rbarreiros/FV1-Touch/Build/FTDI Connection.JPG

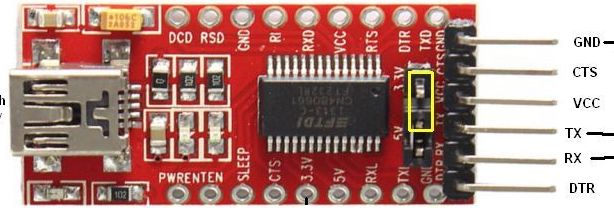
Build/FTDI Connection.JPG
