rbarreiros/FV1-Touch/Build/stm32f103.png

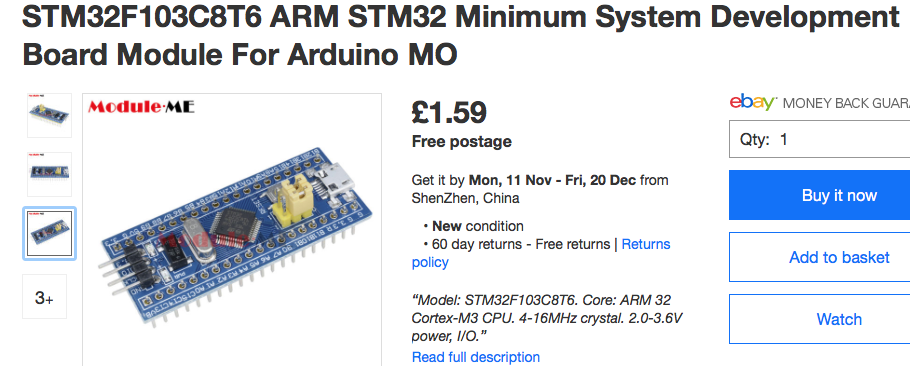
Build/stm32f103.png
