rbarreiros/FV1-Touch/Images/IMG_4687.jpeg

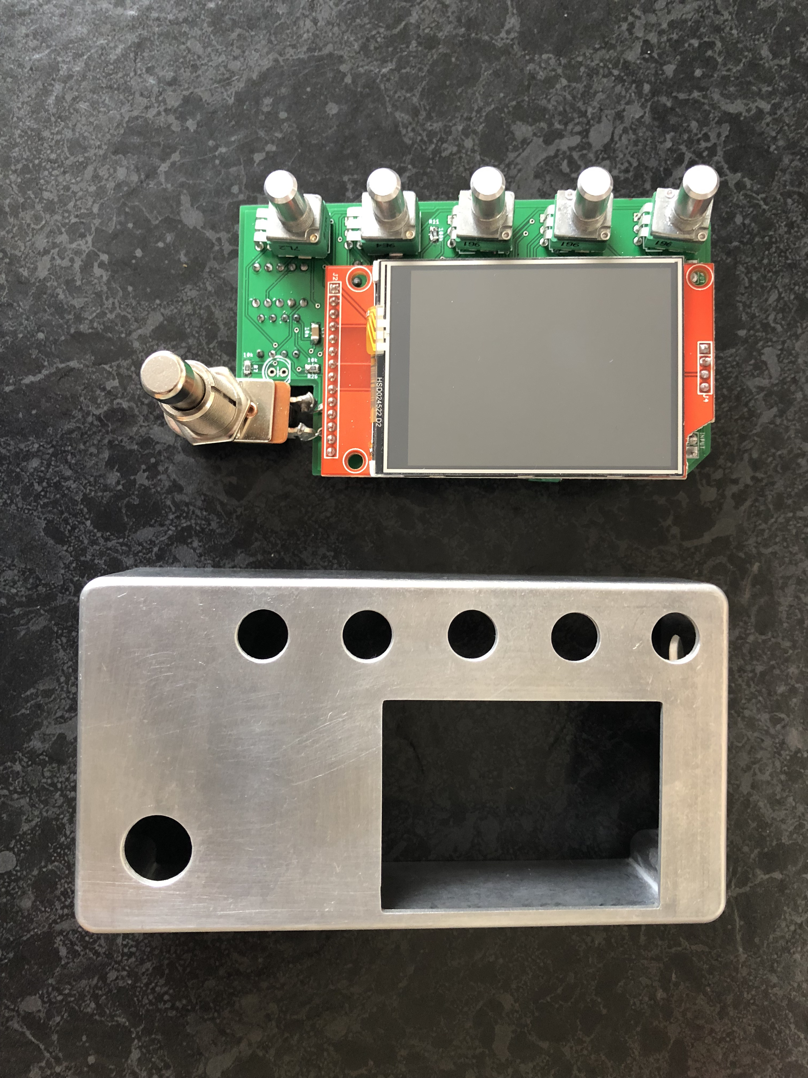
Images/IMG_4687.jpeg
