rbarreiros/FV1-Touch/Images/IMG_5030.JPG

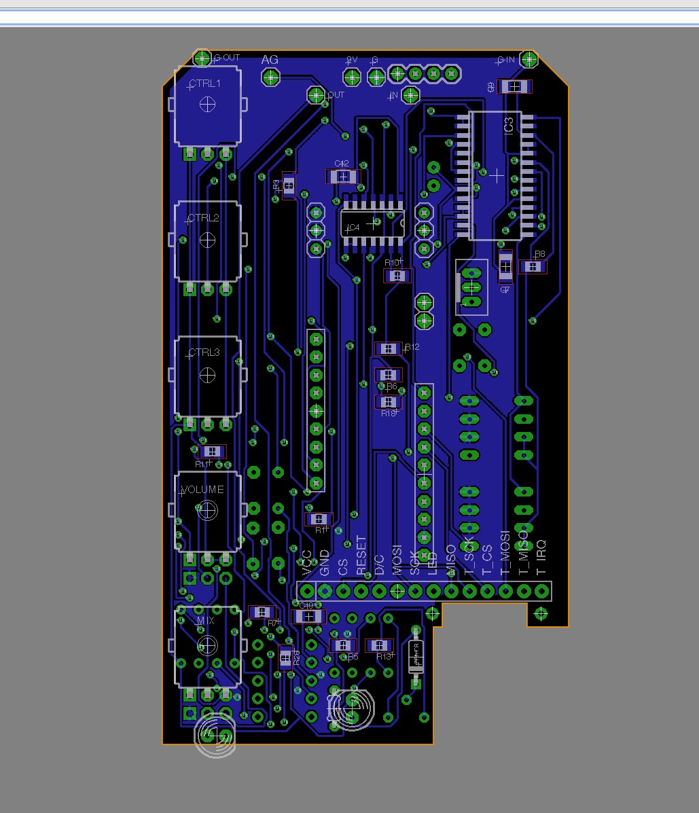
Images/IMG_5030.JPG
