rbarreiros/FV1-Touch/Images/IMG_5032.JPG

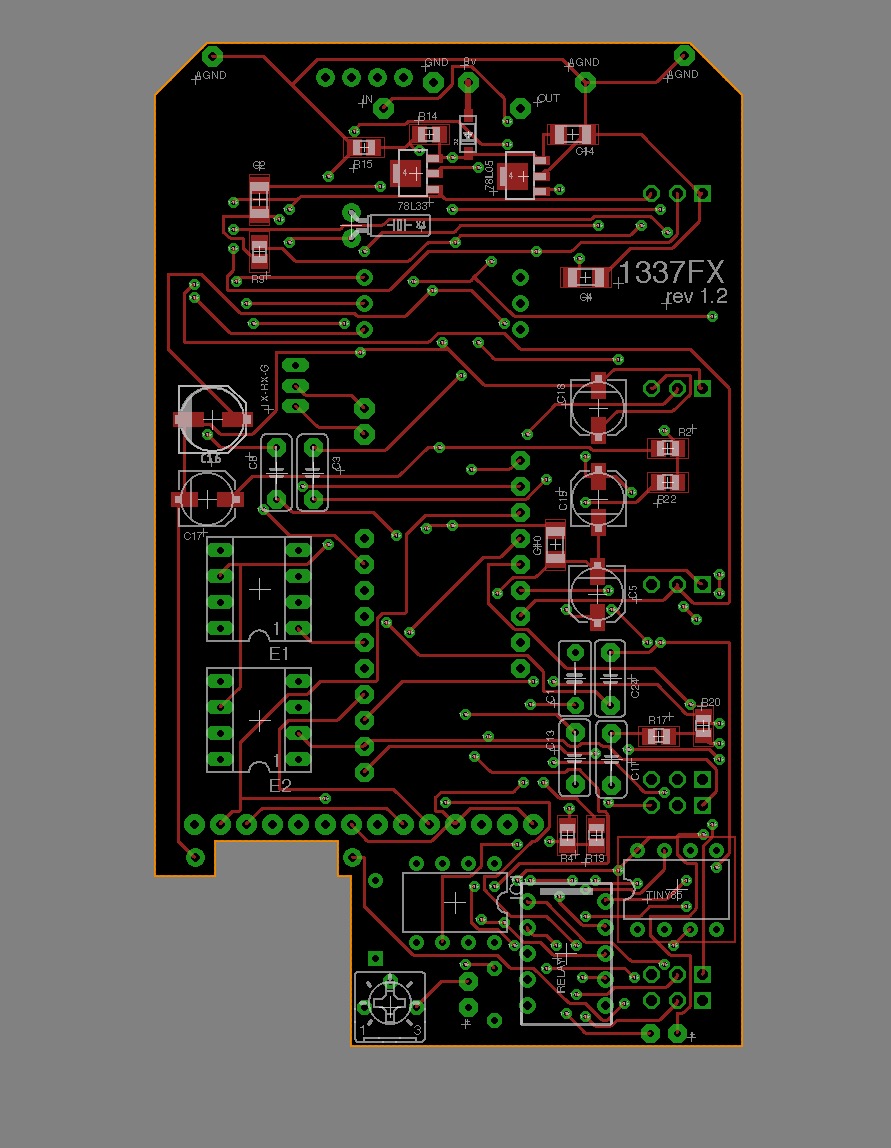
Images/IMG_5032.JPG
