rbarreiros/FV1-Touch/Images/IMG_5121.jpeg

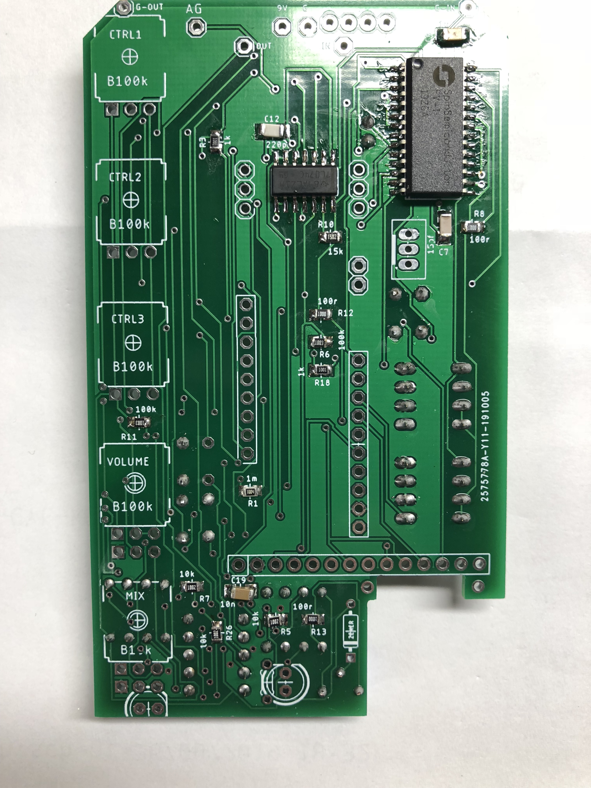
Images/IMG_5121.jpeg
