rbarreiros/FV1-Touch/Images/IMG_5122 2.jpeg

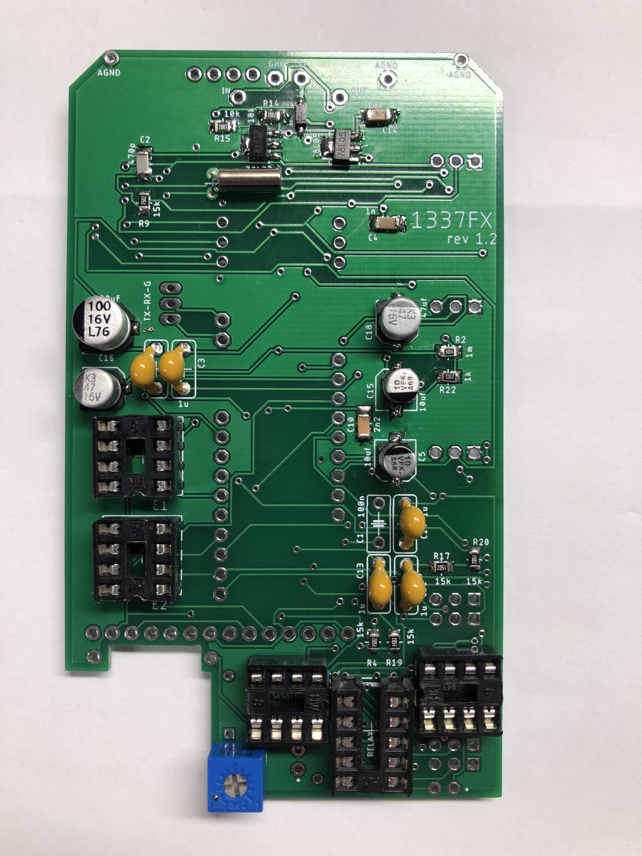
Images/IMG_5122 2.jpeg
