rbarreiros/FV1-Touch/Images/IMG_5137.jpeg

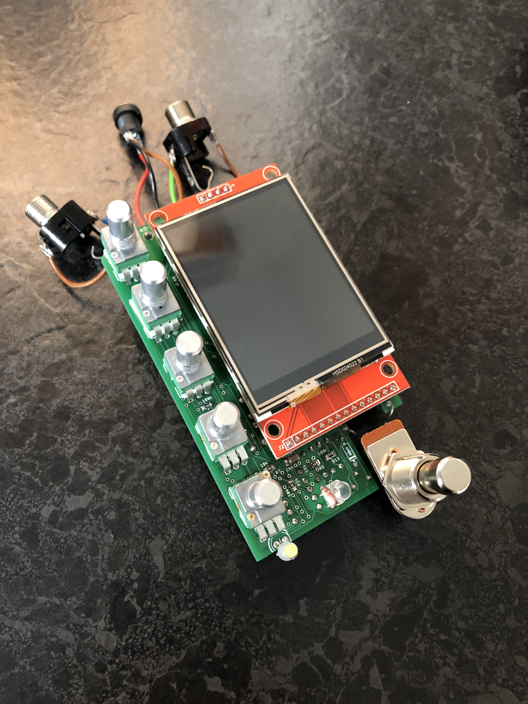
Images/IMG_5137.jpeg
