rbarreiros/FV1-Touch/Images/IMG_5140.jpeg

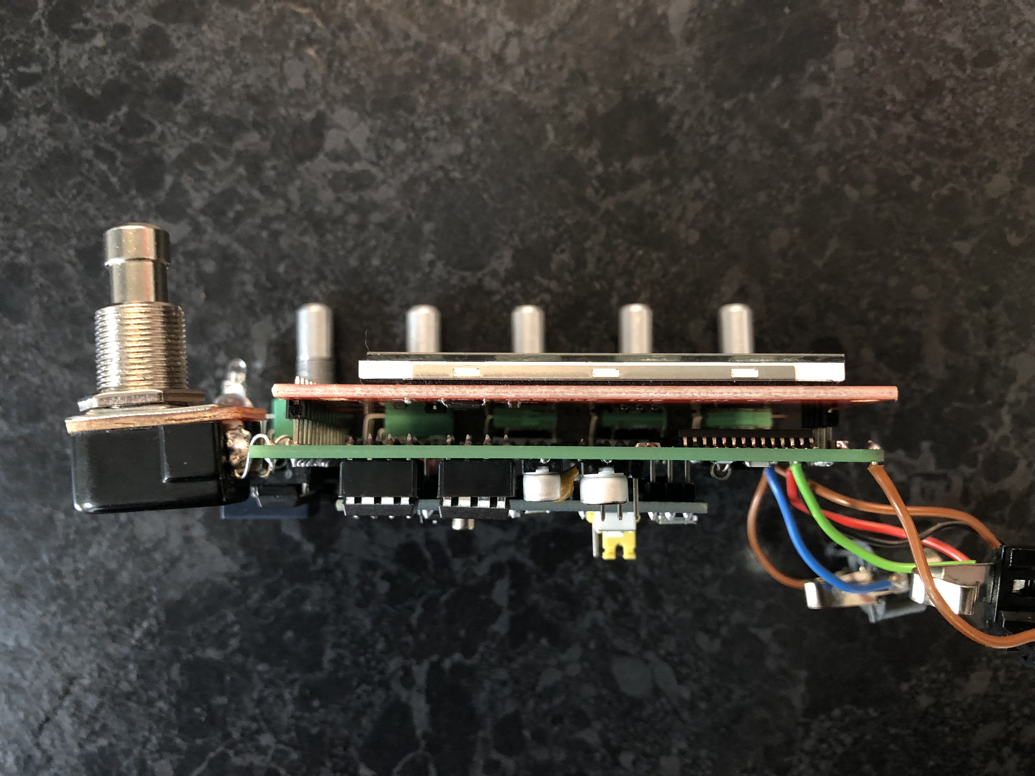
Images/IMG_5140.jpeg
