rbarreiros/FV1-Touch/Images/IMG_5143.jpeg

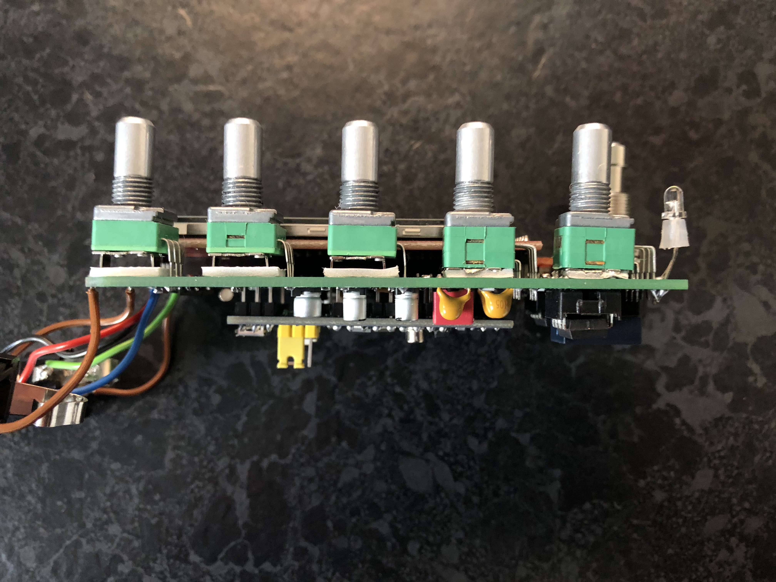
Images/IMG_5143.jpeg
