rbarreiros/FV1-Touch/Images/IMG_5144.jpeg

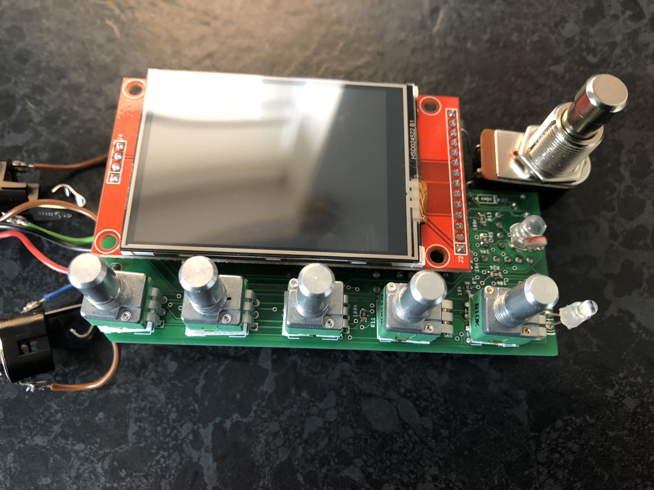
Images/IMG_5144.jpeg
