rbarreiros/FV1-Touch/Images/IMG_5166.jpeg

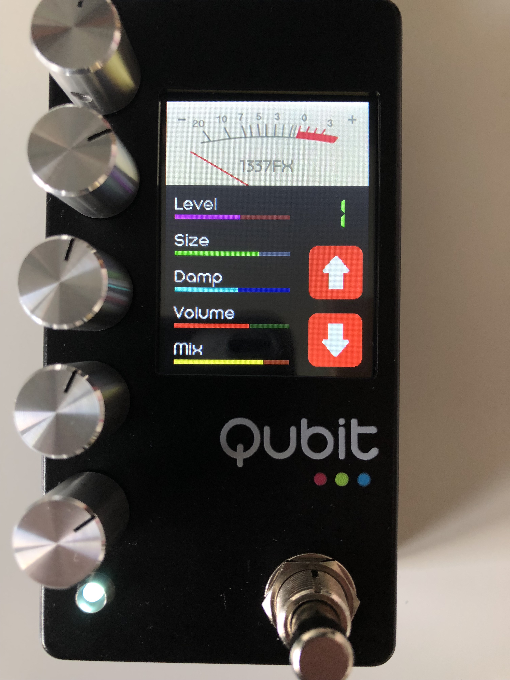
Images/IMG_5166.jpeg
