rbarreiros/FV1-Touch/Images/IMG_5245.jpeg

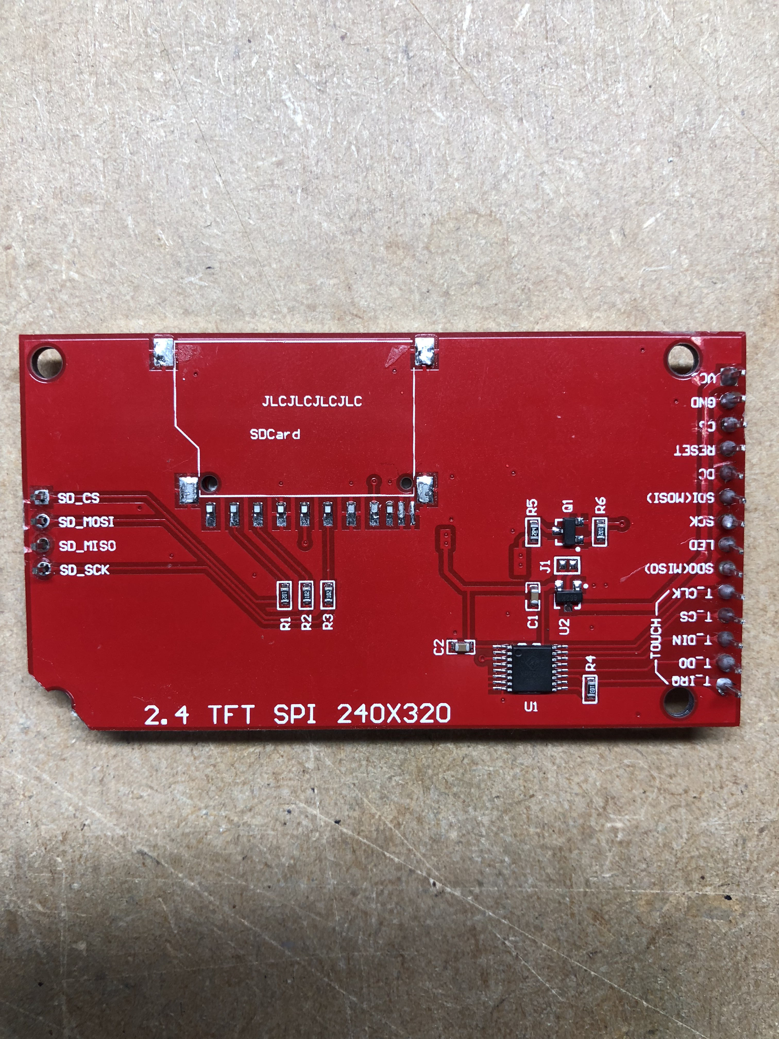
Images/IMG_5245.jpeg
