rbarreiros/FV1-Touch/Images/IMG_5246.jpeg

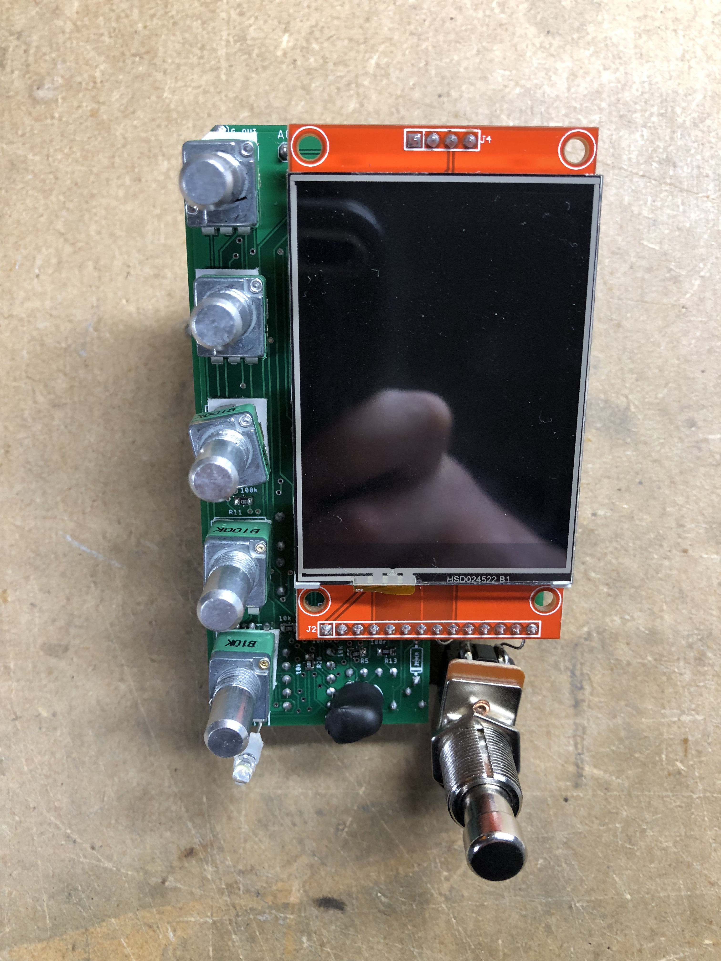
Images/IMG_5246.jpeg
