rbarreiros/FV1-Touch/Images/IMG_5289.jpeg

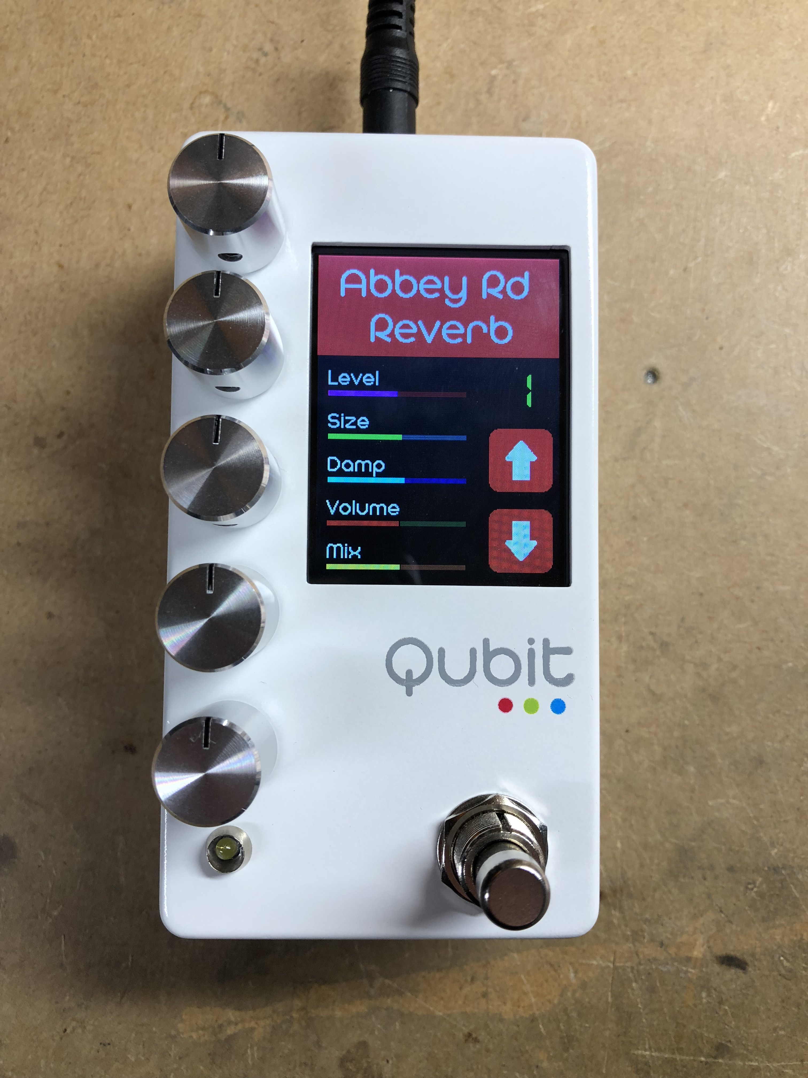
Images/IMG_5289.jpeg
