rbarreiros/FV1-Touch/Images/IMG_5290.jpeg

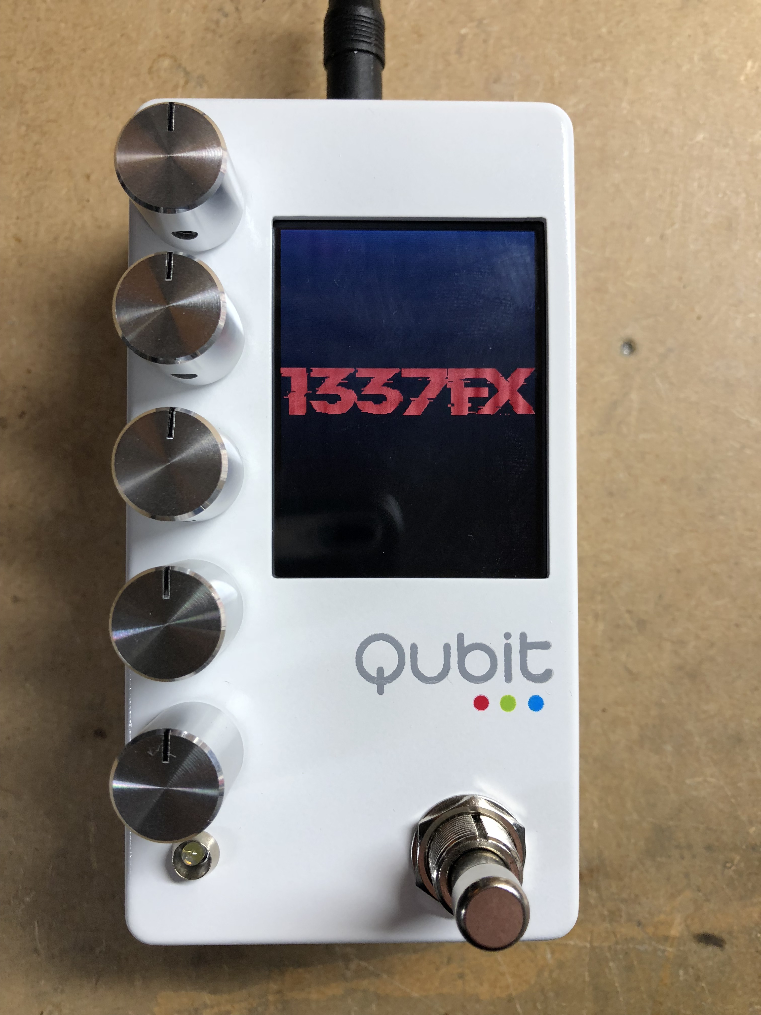
Images/IMG_5290.jpeg
