rbarreiros/FV1-Touch/Images/IMG_5298.jpeg

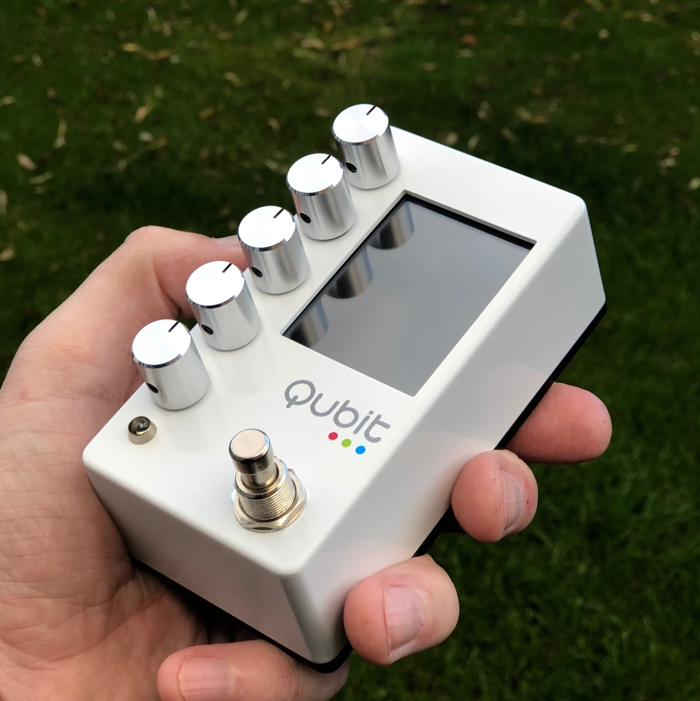
Images/IMG_5298.jpeg
