rbarreiros/FV1-Touch/Spincad/MN3011 Delay.jpg

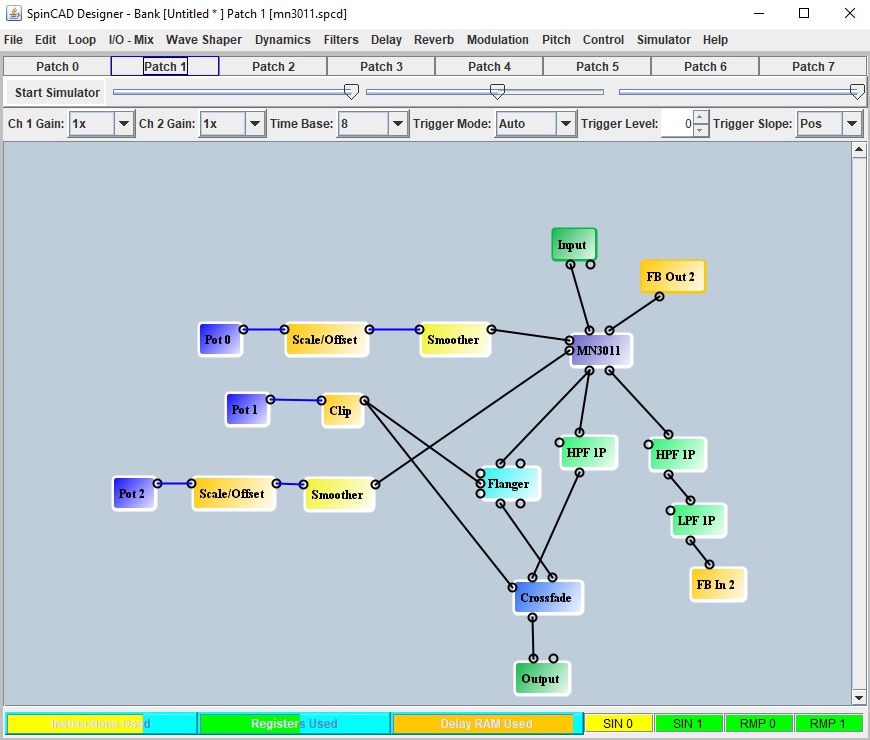
Spincad/MN3011 Delay.jpg
