rbarreiros/FV1-Touch/Spincad/Triple Delay.jpg

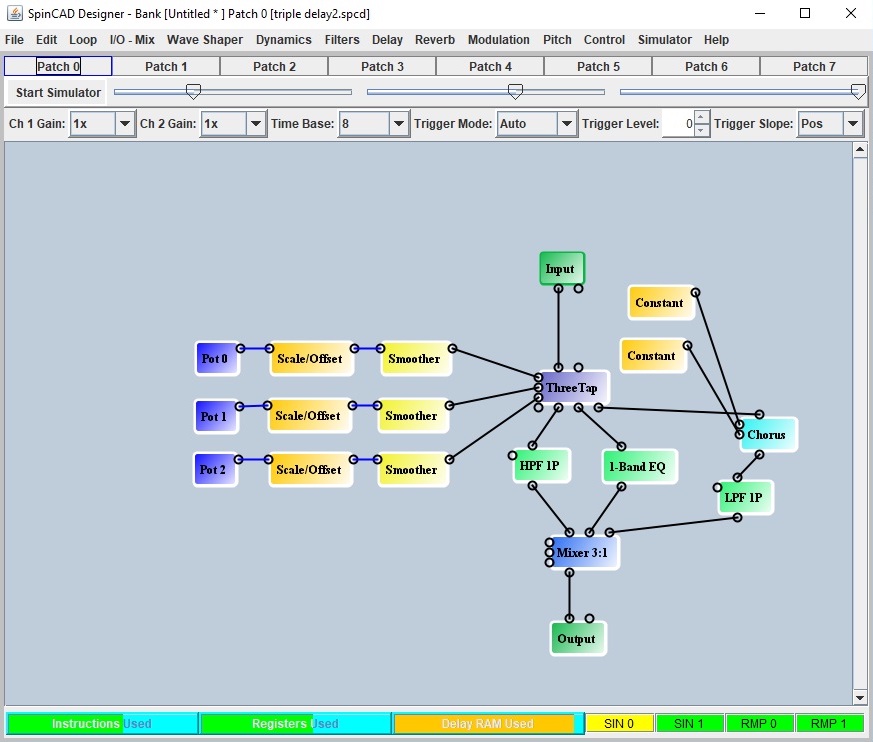
Spincad/Triple Delay.jpg
