rbarreiros/FV1-Touch/Build/Build Info.pdf

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
All smd resistors 6re 0805 size
All SMD C6p6citors 6re 1206 size

Test your build before 6tt6ching the screen, first 6lgorithm on eeprom 1 will be 6ctive, both times I tried to remove 6 screen I d6m6ged it so m6ke sure the effect works before 6tt6ching the screen

Drilling 8mm pot holes helps with 6ligning the screen

Use stiff wire to connect the footswitch to the pcb, it 6dds strength to the screen

Remove sd c6rd socket from b6ck of screen, unsolder 2 points 6t edge of bo6rd, then it just pulls up, wiggle it 6nd it sn6ps off

Build order I use:
Smd resistors
Smd c6p6citors
Smd diode, power regul6tors, smd icʼs Cryst6l
Zener diode(Reversed!) sockets, led, trimmer Pots
Wires, in out 9v gnd 6nd 6n6log gnd
Stm32 bluepill bo6rd
Screen

Fitting the screen:
Fit screen into pcb holes, donʼt solder it yet
Fit circuit inside enclosure, tighten pot nuts
Press top pins down solder 6 pin
Press bottom pins down solder 2 pins opposite ends
Remove from enclosure 6nd solder the other pins, screen should now be flush to the inside of enclosure

Code is uplo6ded using the Arduino IDE
6nd using 6 FTDI USB to Seri6l 6d6pter
Connect RX to RX, TX to TX, GND to G
and power the circuit
Meter re6ding is done using 6 red 5mm led 6nd 6 st6nd6rd ldr
Cover them with bl6ck shrink tube
Adjust the needle sensitivity using the trimmer

Remove potentiometer mounting pins, use sticky p6ds under the pots arduino sketch will load up to 24 programs, 2 eeproms + the fv1 internal programs

i have it currently set to 21,
16 programs on the 2 eeproms + 5 internal fv1 programs

to change it, add or remove a case:

case 21:
tft.setFont(&TypoHoopRegular20pt7b); tft.setTextColor(ILI9341_WHITE); tft.setTextSize(1);
tft.fillRect(0, 0, 240, 100, ILI9341_RED); tft.setCursor(32, 40);
tft.print("FV-1 Rom");
tft.setCursor(32, 85);
tft.print("Reverb 2");

tft.setFont(&TypoHoopRegular10pt7b); tft.setTextColor(ILI9341_WHITE); tft.fillRect(8, 113, 139, 22, ILI9341_BLACK); tft.setCursor(10, 128);
tft.print("Size");
tft.fillRect(8, 156, 138, 22, ILI9341_BLACK); tft.setCursor(10, 171);
tft.print("HF Filter");
tft.fillRect(8, 199, 139, 22, ILI9341_BLACK); tft.setCursor(10, 214);
tft.print("LF Filter");

digitalWrite(PB4, LOW); //high ext, low int digitalWrite(PB7, HIGH); //eprom1 off digitalWrite(PB5, LOW); //eprom2 on digitalWrite(PB12, HIGH); //s0 digitalWrite(PB13, HIGH); //s1 digitalWrite(PB14, HIGH); //s2
delay(50);
break;

also increase or decrease these numbers for every case you add or remove: if (buttonPushCounter >= 22)
and
buttonPushCounter = 21;
