rbarreiros/FV1-Touch/Build/fv1 touch drill.pdf

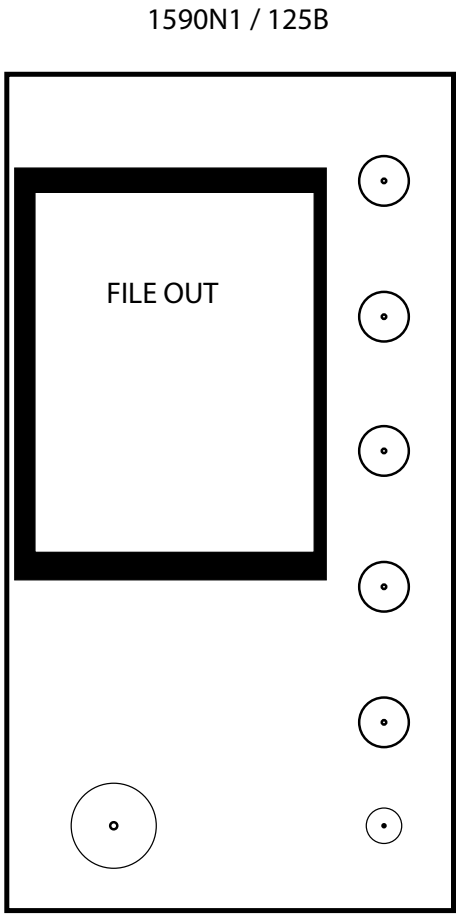
[picture p23: figure]
FILE OUT
