rbarreiros/FV1-Touch/Build/2.4_ ili9341 touch.png

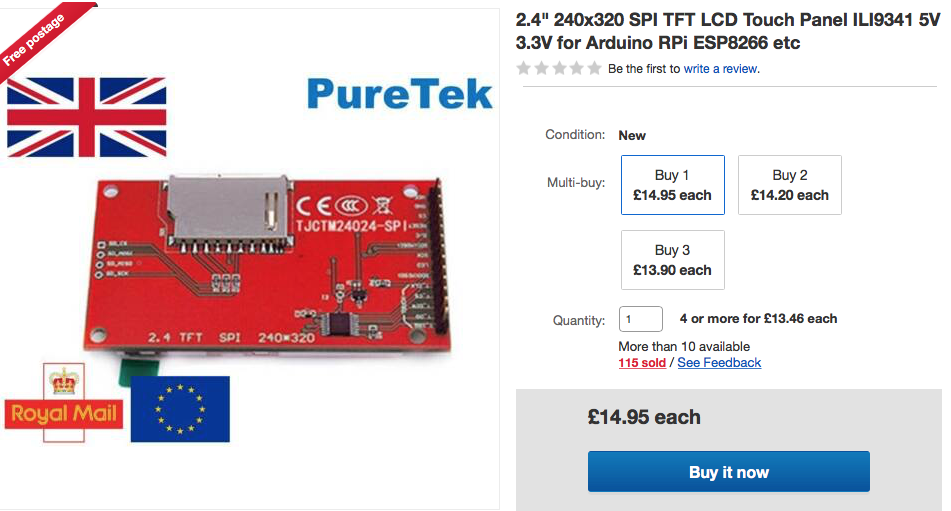
Build/2.4_ ili9341 touch.png
