rbarreiros/FV1-Touch/Build/FTDI.png

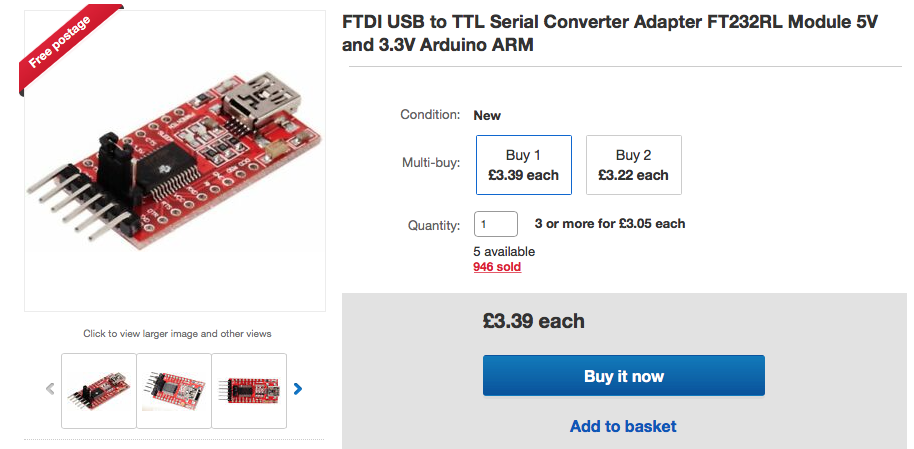
Build/FTDI.png
