rbarreiros/FV1-Touch/(threads)

Thread 1 (2019-11-28):

SPIClass mySPI

leetut, 2019-11-28:
on line 117
SPIClass mySPI(1); //Create an SPI instance on default SPI port (SPI 1)
is missing the (1)
wouldn't compile without it

rbarreiros, 2019-11-28:
I'm surprised it compiled with it, because you're using Dan drown stm32 Arduino port that's why it wouldn't compile, as Dan drown stm32 port requires the spi port in the constructor, but, bounce2 doesn't compile with that stm32 port, hence I use this (more compatible with latest Arduino libraries) stm32duino port:

https://github.com/stm32duino

With this one, spi constructor with default settings doesn't need any parameter and all libs compile properly.

rbarreiros, 2019-11-28:
Check the file header.

Closed 2019-11-29.

Thread 2 (2019-11-28):

disableDebugPorts();

leetut, 2019-11-28:
disableDebugPorts();
is needed to be able to use PB3 & PB4 pins as GPIO pins

rbarreiros, 2019-11-28:
Didn't notice on the schematic they were being used, as its stated in the start of the file, I used another stm32 to Arduino port (a more standard one) that doesn't have that function, shouldn't be hard to port (I would guess all you need is to pinmode those ports)

rbarreiros, 2019-11-28:
After further reading (have no idea how Dan drown stm32 port works) if you use the port I was using, you don't need to call disabledebugports, just set the ports as outputs or inputs.

Closed 2019-11-29.
