rbarreiros/FV1-Touch/Eagle/FV1 Touch.brd

## EAGLE design Eagle/FV1 Touch.brd (2019-11-26)

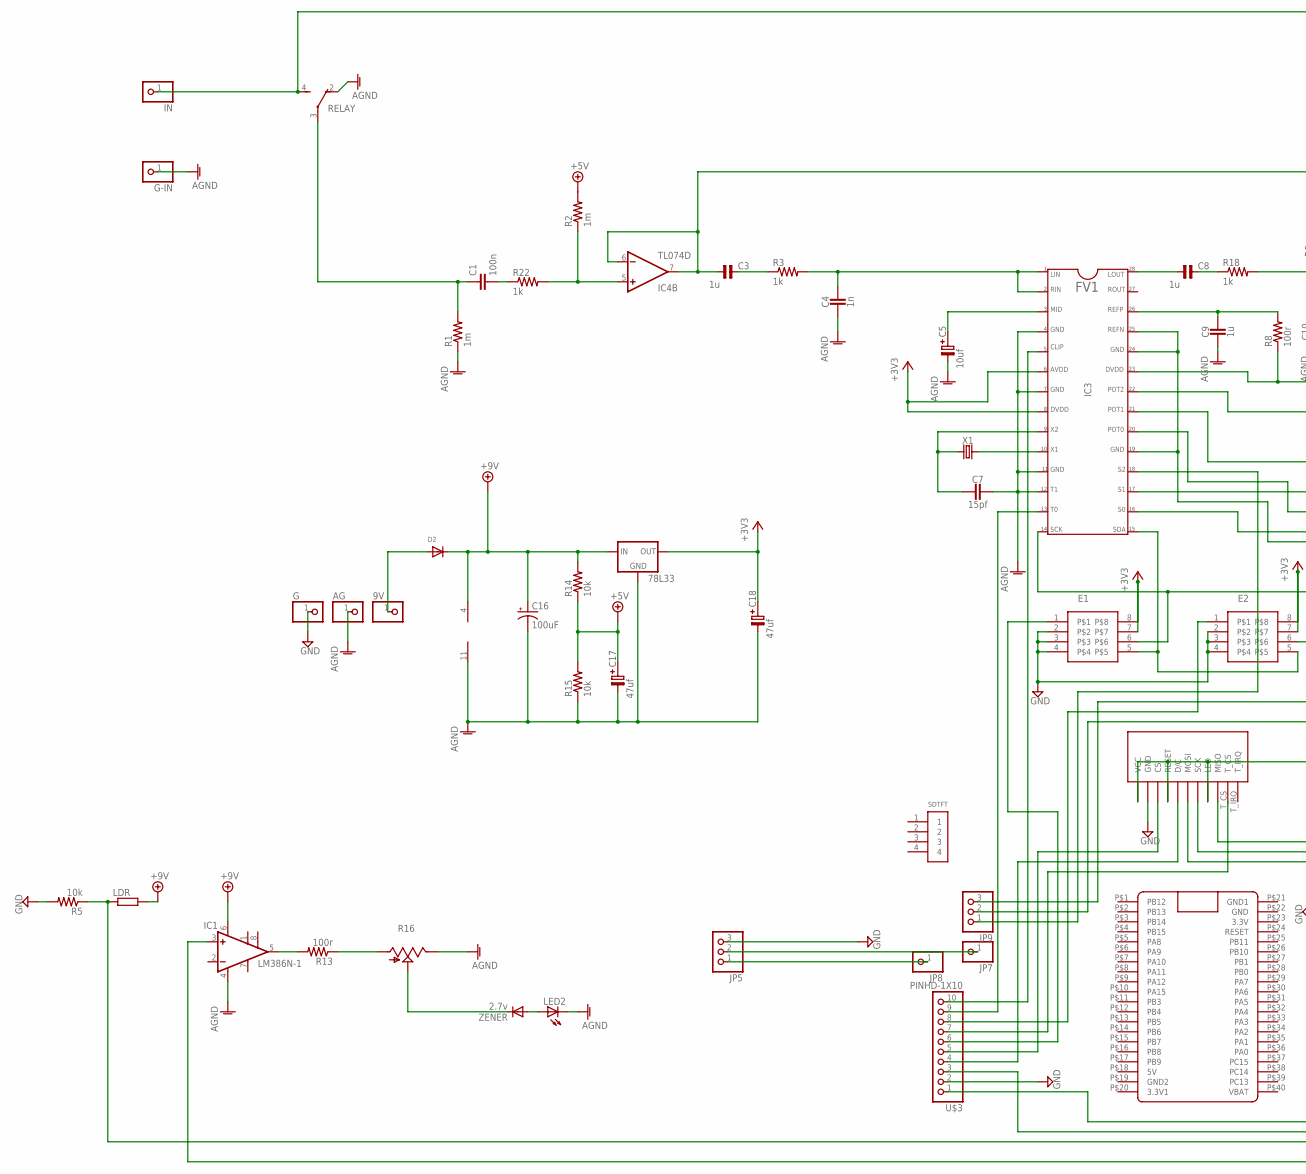
[picture p26: schematic FV1 Touch.sch, part in row 1, column 1]

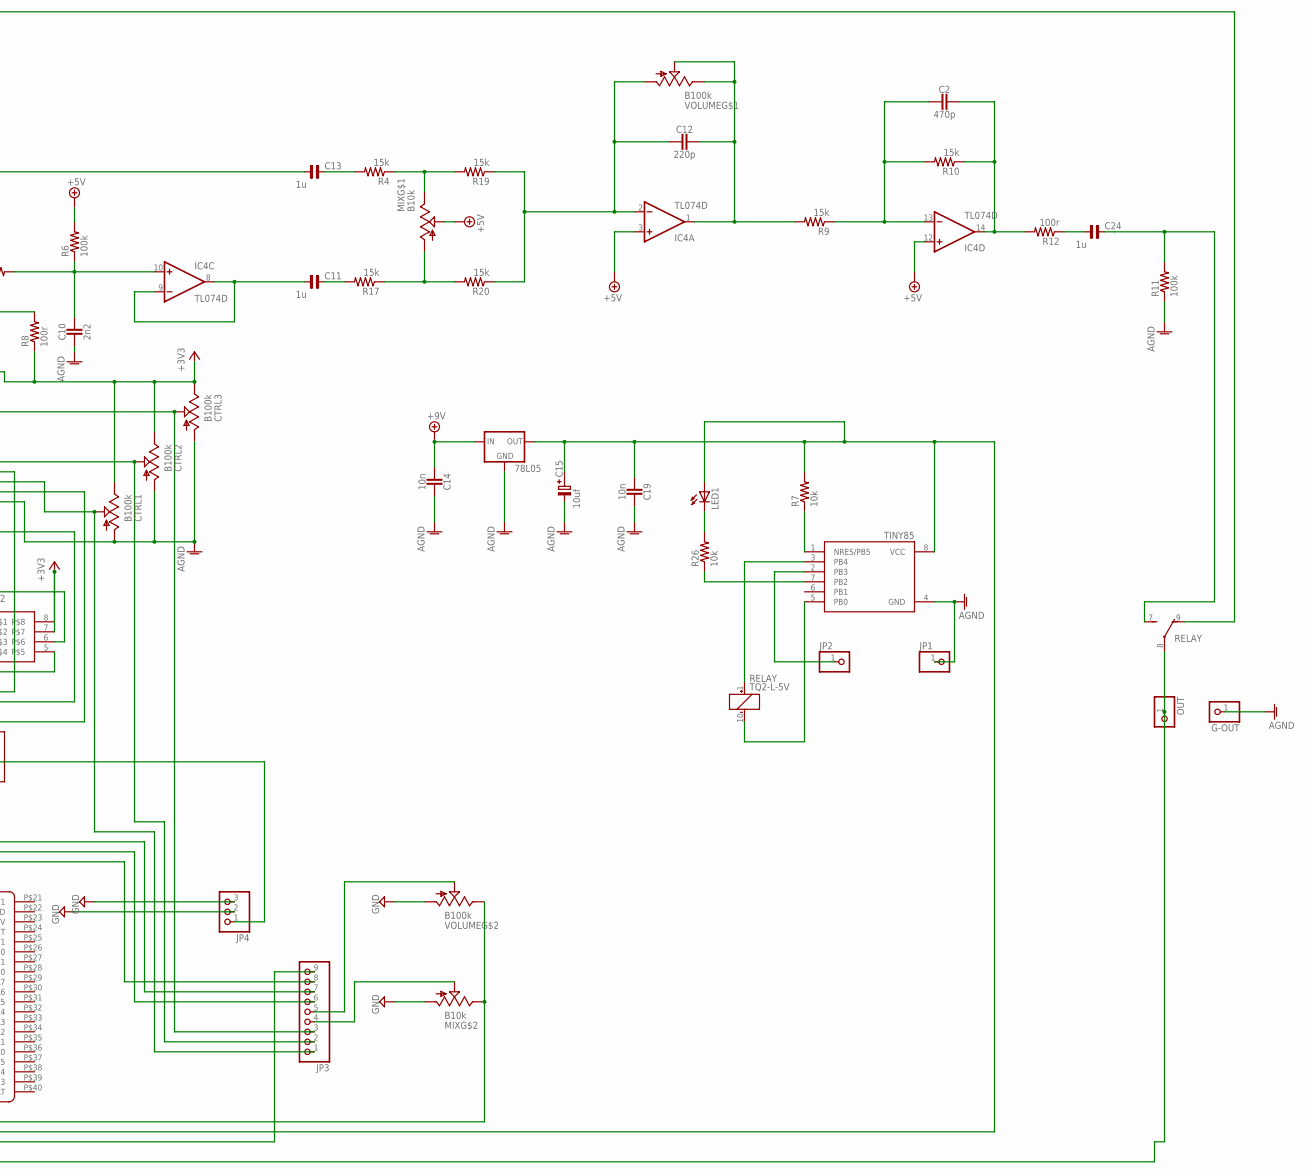
[picture p27: schematic FV1 Touch.sch, part in row 1, column 2]

Parts:
9V: PINHD-1X1; 1X01
78L05, 78L33: 78LXX-SOT89; SOT89
AG: PINHD-1X1; 1X01
C1: 100n; C5B3
C2: 470p; RESISTOR_C1206
C3, C8, C11, C13, C24: 1u; C5,0-7,5X3,0
C4: 1n; RESISTOR_C1206
C5, C15: 10uf; SV-C
C7: 15pf; RESISTOR_C1206
C9: 1u; RESISTOR_C1206
C10: 2n2; RESISTOR_C1206
C12: 220p; RESISTOR_C1206
C14, C19: 10n; RESISTOR_C1206
C16: 100uF; PANASONIC_D
C17, C18: 47uf; SV-C
CTRL1, CTRL2, CTRL3: B100k; 9MM_SNAP-IN_POT
D2: DIODESOD-123; SOD-123
E1, E2: -EEPROM; SOCKED-08
G: PINHD-1X1; 1X01
G-IN: PINHD-1X1; 1X01
G-OUT: PINHD-1X1; 1X01
IC1: LM386N-1; DIL08
IC3: FV1; SO1C28
IC4: TL074D; SO14
IN: PINHD-1X1; 1X01
J1: SPI_TFT_DISPLAY_TOUCH; SPI_DISPLAY_TOUCH
JP1, JP2: PINHD-1X1CB; 1X01-CLEANBIG
JP3: PINHD-1X9; 1X09-BIG
JP4, JP5, JP9: PINHD-1X3; 1X03
JP7, JP8: PINHD-1X1; 1X01
LDR: R-EU_0204/5; 0204/5
LED1, LED2: LED5MM
MIX: B10k; DUAL_9MM_SNAP-IN_POT
OUT: PINHD-1X1; 1X01
R1, R2: 1m; R0805
R3, R18, R22: 1k; R0805
R4, R9, R10, R17, R19, R20: 15k; R0805
R5, R7, R14, R15, R26: 10k; R0805
R6, R11: 100k; R0805
R8, R12, R13: 100r; R0805
R16: TRIM_US-B25P; B25P
RELAY: TQ2-L-5V; TQ2
SDTFT: 1X4-BIG; 1X04-BIG
TINY85: ATTINY85-20P; PDIP08_300MIL
U$1: BLUE_PILL
U$3: PINHD-1X10; 1X10-BIG
VOLUME: B100k; DUAL_9MM_SNAP-IN_POT
X1: CRYSTALPTH-2X6-KIT; CRYSTAL-PTH-2X6-CYL-KIT
ZENER: 2.7v; DO35-7

Connections:
+3V3: 78L33.1 (OUT), C18.+, CTRL1.3 (E), CTRL2.3 (E), CTRL3.3 (E), E1.7, E1.8, E2.7, E2.8, IC3.6, IC3.8, IC3.23, R8.1
+5V: C17.+, IC4.3 (+IN), IC4.12 (+IN), MIX.2 (S), R2.2, R6.2, R14.1, R15.2
+9V: 78L05.3 (IN), 78L33.3 (IN), C14.2, C16.+, D2.C, IC1.6 (VS), IC4.4 (V+), LDR.2, R14.2
AGND: 78L05.2 (GND), 78L33.2 (GND), AG.1, C4.2, C5.-, C7.1, C9.2, C10.2, C14.1, C15.-, C16.-, C17.-, C18.-, C19.1, CTRL1.1 (A), CTRL2.1 (A), CTRL3.1 (A), G-IN.1, G-OUT.1, IC1.4 (GND), IC3.4, IC3.7, IC3.11, IC3.12, IC3.19, IC3.24, IC3.25, IC4.11 (V-), JP1.1, LED2.K (C), R1.1, R11.1, R15.1, R16.E, RELAY.2 (O), TINY85.4 (GND)
GND: E1.2, E1.3, E1.4, E2.2, E2.3, E2.4, G.1, J1.GND, JP4.2, JP4.3, JP5.3, MIX.1B (A), R5.2, U$3.2, VOLUME.1B (A)
GND1: U$1.P$21 (GND1)
unnamed: C1.2, R22.1
unnamed: IC4.5 (+IN), R2.1, R22.2
unnamed: C3.1, C13.1, IC4.6 (-IN), IC4.7 (OUT)
unnamed: C8.1, IC3.28
unnamed: C4.1, IC3.1, IC3.2, R3.2
unnamed: C8.2, R18.1
unnamed: C3.2, R3.1
unnamed: C10.1, IC4.10 (+IN), R6.1, R18.2
unnamed: C11.1, IC4.8 (OUT), IC4.9 (-IN)
unnamed: C11.2, R17.2
unnamed: MIX.1 (A), R17.1, R20.2
unnamed: C24.2, R11.2, RELAY.7 (S)
unnamed: MIX.3 (E), R4.1, R19.2
unnamed: C13.2, R4.2
unnamed: C2.1, IC4.14 (OUT), R10.1, R12.2
unnamed: C24.1, R12.1
unnamed: C1.1, R1.2, RELAY.3
unnamed: C12.2, IC4.2 (-IN), R19.1, R20.1, VOLUME.1 (A)
unnamed: C2.2, IC4.13 (-IN), R9.1, R10.2
unnamed: C12.1, IC4.1 (OUT), R9.2, VOLUME.2 (S), VOLUME.3 (E)
unnamed: J1.CS, U$3.5
unnamed: J1.D/C, U$3.4
unnamed: J1.MOSI, J1.T_MOSI (MOSI), JP3.8
unnamed: C5.+, IC3.3
unnamed: IC3.13, U$3.9
unnamed: CTRL3.2 (S), IC3.22, JP3.3
unnamed: C7.2, IC3.9, X1.1
unnamed: C9.1, IC3.26, R8.2
unnamed: CTRL2.2 (S), IC3.21, JP3.2
unnamed: CTRL1.2 (S), IC3.20, JP3.1
unnamed: J1.SCK, J1.T_SCK (SCK), JP3.6
unnamed: J1.MISO, J1.T_MISO (MISO), JP3.7
unnamed: IC3.10, X1.2
unnamed: J1.T_CS, U$3.7
unnamed: JP5.2, JP7.1
unnamed: E1.6, E2.6, IC3.14
unnamed: E1.5, E2.5, IC3.15
unnamed: JP5.1, JP8.1
unnamed: J1.LED, J1.RESET, J1.VCC, JP4.1
unnamed: IC3.17, JP9.2
unnamed: 9V.1, D2.A
unnamed: IC3.18, JP9.1
unnamed: E1.1, U$3.6
unnamed: JP3.4, MIX.2B (S)
unnamed: 78L05.1 (OUT), C15.+, C19.2, LED1.A, R7.2, TINY85.8 (VCC), U$3.3
unnamed: RELAY.1 (+), TINY85.3 (PB4)
unnamed: R7.1, TINY85.1 (NRES/PB5)
unnamed: RELAY.10 (-), TINY85.5 (PB0)
unnamed: JP2.1, TINY85.2 (PB3)
unnamed: R26.1, TINY85.7 (PB2)
unnamed: LED1.K (C), R26.2
unnamed: IN.1, RELAY.4 (S), RELAY.9 (O)
unnamed: IC1.3 (+IN), OUT.1, RELAY.8
unnamed: JP3.5, VOLUME.2B (S)
unnamed: IC3.16, JP9.3
unnamed: MIX.3B (E), U$3.1, VOLUME.3B (E)
unnamed: R16.S, ZENER.C
unnamed: E2.1, U$3.8
unnamed: IC3.5, U$3.10
unnamed: IC1.5 (OUT), R13.2
unnamed: R13.1, R16.A
unnamed: LED2.A, ZENER.A
unnamed: JP3.9, LDR.1, R5.1

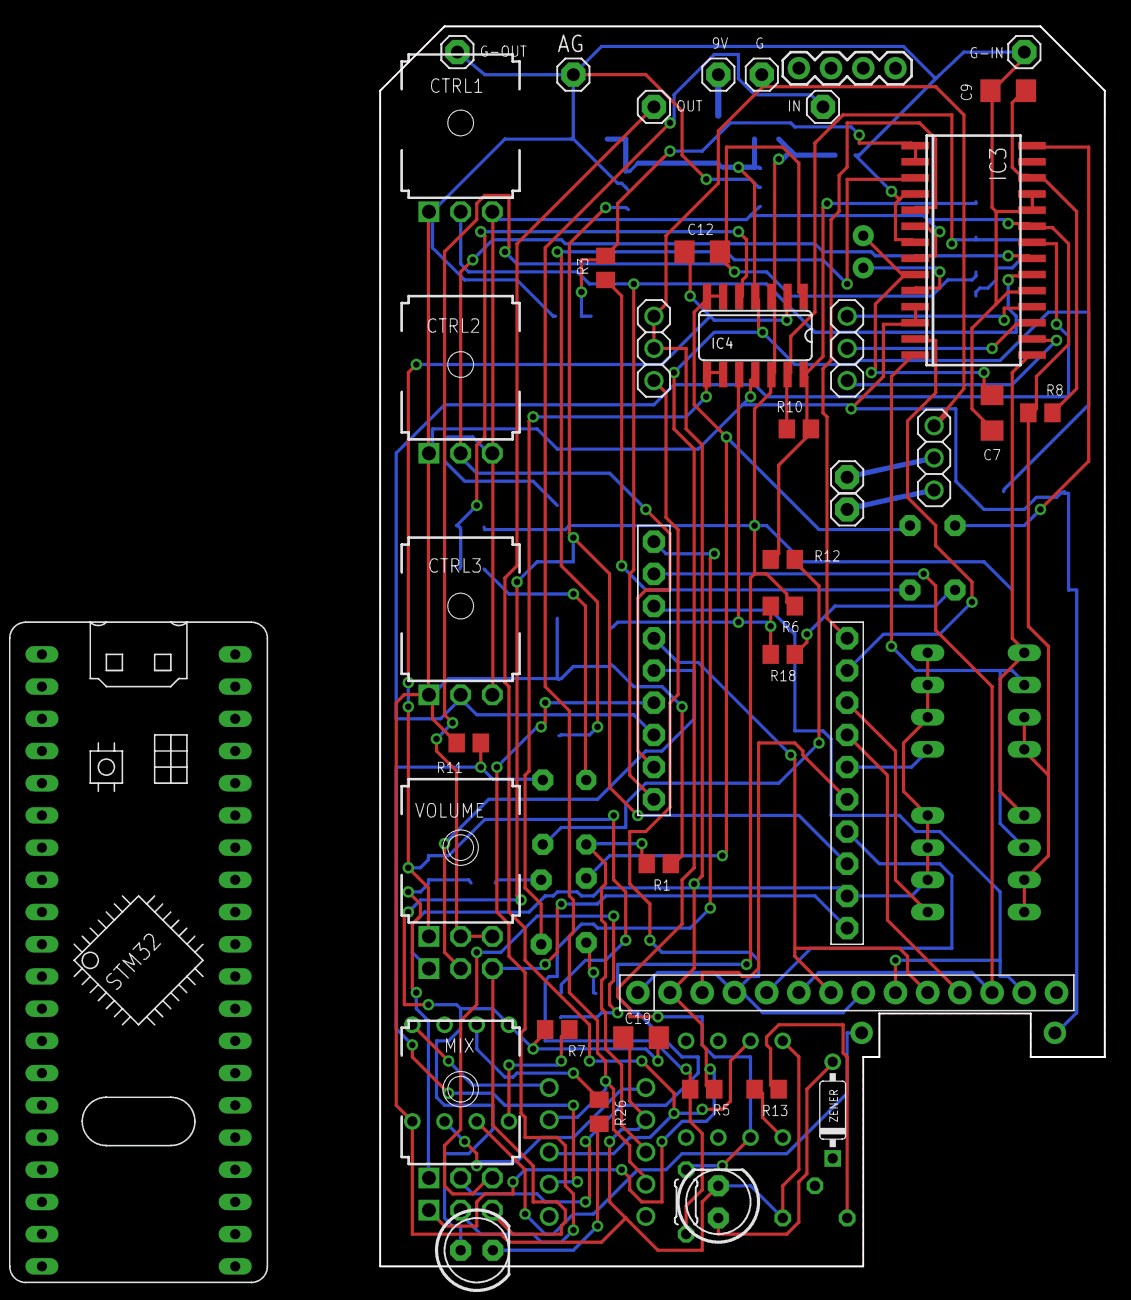
[picture p28: board FV1 Touch.brd from above]

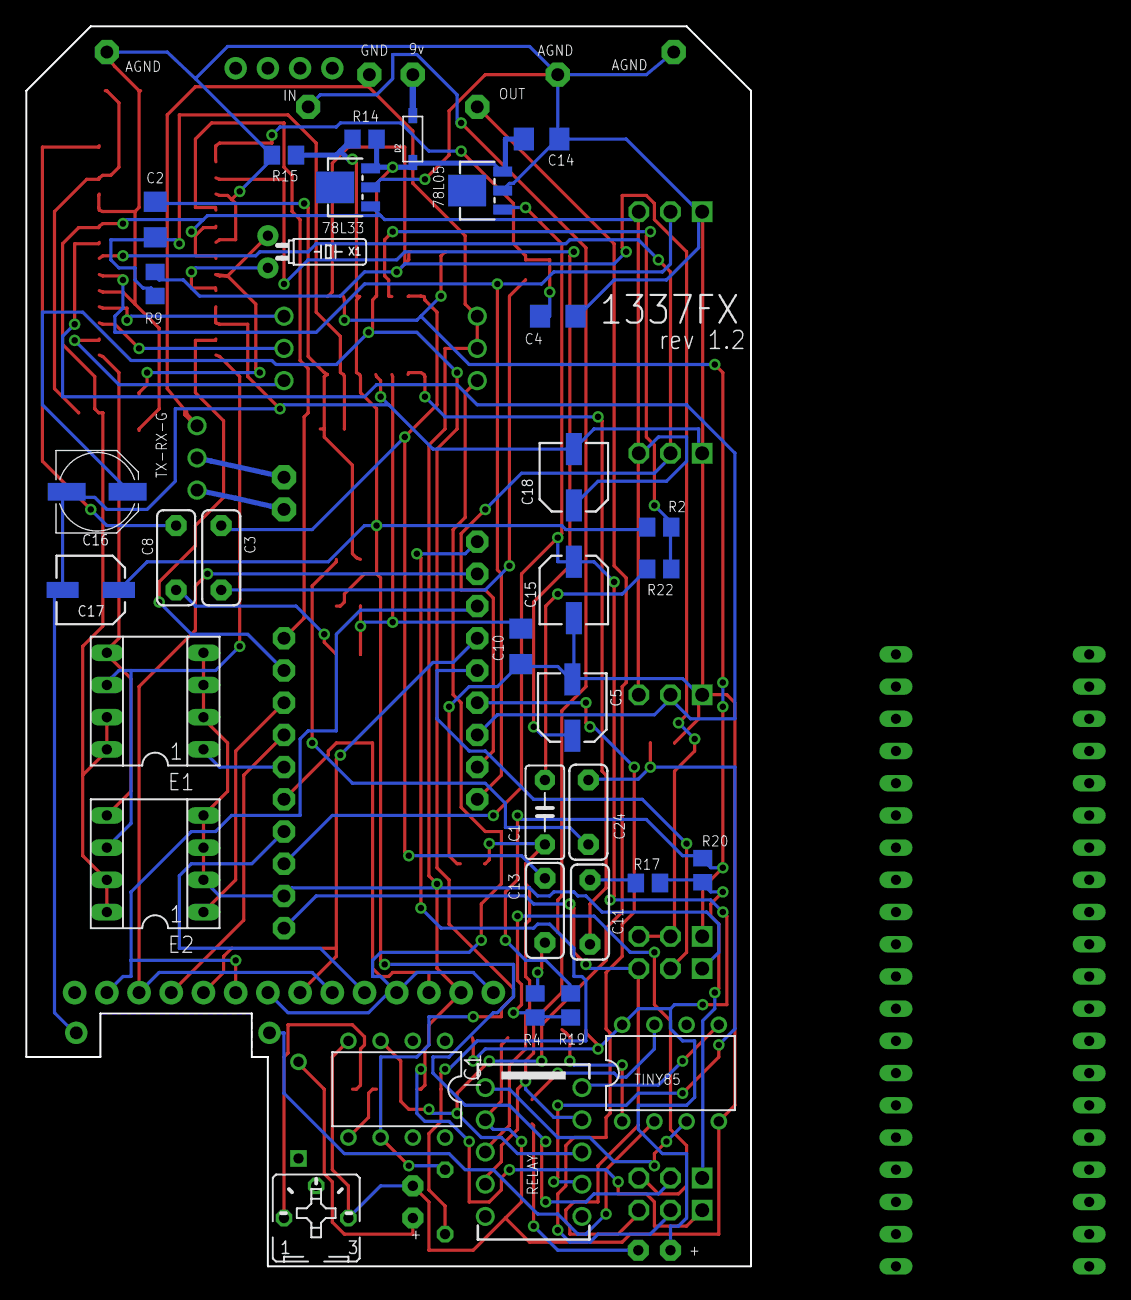
[picture p29: board FV1 Touch.brd from below]

Board: 2 copper layers, 57.1 x 97.8 mm, 80 parts (34 on the bottom side), 68 nets.
