rbarreiros/FV1-Touch/firmware/sketch/TouchPedal.ino

// https://www.facebook.com/1337fx/
// https://www.instagram.com/1337_fx/

/**
 * Use this stm32 arduino version as the others don't play well with other original
 * arduino libs.
 * 
 * https://github.com/stm32duino/BoardManagerFiles/raw/master/STM32/package_stm_index.json
 * 
 * Using arduino-cli to compile and/or upload the sketch
 * 
 * arduino-cli compile -b STM32:stm32:GenF1 --build-properties upload.maximum_size=131072 TouchPedal.ino
 *
 *
 * This sketch requires the following libraries:
 *
 * Adafruit GFX		https://github.com/adafruit/Adafruit-GFX-Library
 * Adafruit ILI9341	https://github.com/adafruit/Adafruit_ILI9341
 * XPT2046 Touchscreen	https://github.com/PaulStoffregen/XPT2046_Touchscreen
 * Bounce2 		https://github.com/thomasfredericks/Bounce2
 * Arduino SPI
 *
 */ 

#include <Adafruit_GFX.h>
#include <Adafruit_ILI9341.h>
#include <XPT2046_Touchscreen.h>
#include <SPI.h>
#include <Bounce2.h>

// Fonts and graphics

#include "TypoHoop20pt.h"
#include "Typohoop10pt.h"
#include "uparrow.h";
#include "downarrow.h";
#include "bootlogo.h";
#include "digi.h";
#include "meter.h";

// Color defines
#include "colors.h"

// Pin defines
#include "pins.h"

// Global variables

int buttonPushCounter = 1;   // counter for the number of button presses
int buttonState       = 0;   // current state of the button
int lastButtonState   = 0;   // previous state of the button
int reading           = 0;
int meterOn           = false;

volatile byte oldPnumber = 0;
volatile byte NewPnumber = 0;

double p1volts;
double p2volts;
double p3volts;
double p4volts;
double p5volts;

boolean graph_1 = true;
boolean graph_2 = true;
boolean graph_3 = true;
boolean graph_4 = true;
boolean graph_5 = true;

float ltx = 0;    // Saved x coord of bottom of needle
uint16_t osx = 80, osy = 80; // Saved x & y coords
uint32_t updateTime = 0;       // time for next update

int old_analog =  -999; // Value last displayed
int old_digital = -999; // Value last displayed

// Relay defaults & helpers

#define DEBOUNCETIME 25
#define RELAYDELAY   15
#define PRIMETIME    1000
#define DOUBLECLICK  1000

uint8_t state = 0;
int primetime = 0;
int relay_address = 0;
unsigned long lastMillis = 0;
unsigned long doubleMillis = 0;

/**
 *                            USB
 *                        -----------
 *          FV1 S0 PB12 - |         |- GND
 *          FV1 S1 PB13 - |         |- GND
 *          FV1 S2 PB14 - |         |- 3V3
 *                 PB15 - |         |- NRST
 *                 PA8  - |         |- PB11 Relay LED
 *                 PA9  - |         |- PB10
 *                 PA10 - |         |- PB1
 *                 PA11 - |         |- PB0  LDR ???
 *                 PA12 - |         |- PA7  MOSI1 (SPI 1)
 *                 PA15 - |         |- PA6  MISO1 (SPI 1)
 *        FV1 Clip PB3  - |         |- PA5  SCK1  (SPI 1)
 *       FV1 PIN13 PB4  - |         |- PA4  POT4 (Volume)
 *         EEPROM2 PB5  - |         |- PA3  POT5 (Mix)
 *  (Touch) CS_PIN PB6  - |         |- PA2  POT3
 *         EEPROM1 PB7  - |         |- PA1  POT2
 *   (TFT)  TFT_CS PB8  - |         |- PA0  POT1
 *   (TFT)  TFT_DC PB9  - |         |- PC15 Relay Switch
 *                 5V   - |         |- PC14 Relay Coil 2
 *                 GND  - |         |- PC13 Relay Coil 1
 *                 3V3  - |         |- VBAT
 *                        -----------
 *                          | | | |
 *                     3V3 -  | |  - GND
 *                      PA13 -   - PA14
 * 
*/

// Global classes

Adafruit_ILI9341 tft(TFT_CS, TFT_DC);
SPIClass mySPI; //Create an SPI instance on default SPI port (SPI 1)
XPT2046_Touchscreen ts(CS_PIN); // Chip Select pin, SPI port
Bounce sw = Bounce();

void splashScreen(void)
{
  tft.drawBitmap(0, 130, boot, 240, 44, RED);
  delay (100);
  tft.drawBitmap(0, 130, boot, 240, 44, BLUE);
  tft.drawBitmap(0, 130, boot, 240, 44, RED);
  delay (100);
  tft.drawBitmap(0, 130, boot, 240, 44, BLUE);
  tft.drawBitmap(0, 130, boot, 240, 44, RED);

  delay (1000);

  tft.fillScreen(ILI9341_BLACK);
  tft.setFont(&TypoHoopRegular20pt7b);
  tft.setTextColor(ILI9341_WHITE);
  tft.setTextSize(1);
  tft.fillRect(0, 0, 240, 100, ILI9341_RED);
  tft.setCursor(67, 40);
  tft.print("Qubit");
  tft.setCursor(67, 85);
  tft.print("Delay");

  tft.setFont(&TypoHoopRegular10pt7b);
  tft.setTextColor(ILI9341_WHITE);
  tft.fillRect(8, 113, 139, 22, ILI9341_BLACK);
  tft.setCursor(10, 128);
  tft.print("Time");
  tft.fillRect(8, 156, 138, 22, ILI9341_BLACK);
  tft.setCursor(10, 171);
  tft.print("Modulation");
  tft.fillRect(8, 199, 139, 22, ILI9341_BLACK);
  tft.setCursor(10, 214);
  tft.print("Feedback");
  tft.setCursor(10, 257);
  tft.print("Volume");
  tft.setCursor(10, 300);
  tft.print("Mix");

  tft.fillRect(179, 182, 40, 45, ILI9341_WHITE);
  tft.fillRect(179, 260, 40, 45, ILI9341_WHITE);
  tft.drawBitmap(170, 170, upbutton, 64, 64, ILI9341_RED);
  tft.drawBitmap(170, 250, downbutton, 64, 64, ILI9341_RED);

  tft.setFont(&DSEG7_Classic_Mini_Bold_38);
  tft.fillRect(165, 105, 70, 50, ILI9341_BLACK);
  tft.setTextColor(ILI9341_GREEN);
  tft.setTextSize(1);
  tft.setCursor(185, 152);
  tft.print(buttonPushCounter);
}

/**
 * effectOn 
 *
 * Turns effect relay on
 */
void effectOn(void)
{
  digitalWrite(RELAY_LED, LOW);
  digitalWrite(RELAY1, HIGH);
  delay(RELAYDELAY);
  digitalWrite(RELAY1, LOW);
  state = 1;
}

/**
 * effectOff
 * 
 * Turn effect relay off
 */
void effectOff(void)
{
  digitalWrite(RELAY_LED, HIGH);
  digitalWrite(RELAY2, HIGH);
  delay(RELAYDELAY);
  digitalWrite(RELAY2, LOW);
  state = 0;
}


/**
 * setup
 * 
 * sets up all I/O, hardware and initializes stuff
 * 
 */
void setup() 
{
  // FV1 Pins
  pinMode(PB12, OUTPUT); //S0
  pinMode(PB13, OUTPUT); //S1
  pinMode(PB14, OUTPUT); //S2
  pinMode(PB3, INPUT); // fv1 clip
  pinMode(PB4, OUTPUT); //fv1 pin13, high ext, low int

  pinMode(PB7, OUTPUT); //select eeprom1
  pinMode(PB5, OUTPUT); //select eeprom2

  pinMode(PA0, INPUT); // pot1
  pinMode(PA1, INPUT); // pot2
  pinMode(PA2, INPUT); // pot3
  pinMode(PA4, INPUT); // pot4 volume
  pinMode(PA3, INPUT); // pot5 mix

  // Analog meter input is PB0

  digitalWrite(PB7, LOW);  // EEPROM1 on
  digitalWrite(PB5, HIGH); // EEPROM2 off
  digitalWrite(PB4, HIGH); // high ext, low int
  delay (100);
  digitalWrite(PB12, HIGH); //s0
  digitalWrite(PB13, HIGH); //s1
  digitalWrite(PB14, HIGH); //s2

  // True bypass relay
  pinMode(RELAY_SWITCH, INPUT_PULLUP);
  digitalWrite(RELAY_SWITCH, HIGH); // internal pullup
  digitalWrite(RELAY_LED, HIGH); // led off
  pinMode(RELAY_LED, OUTPUT);
  digitalWrite(RELAY1, LOW);
  digitalWrite(RELAY2, LOW);
  pinMode(RELAY1, OUTPUT);
  pinMode(RELAY2, OUTPUT);

  // Please, most of us already use high speed serial !!
  // no more 9600 stuff ! :)
  Serial.begin(115200);
  mySPI.begin();
  tft.begin();
  ts.begin();
  ts.setRotation(1);
  while (!Serial && (millis() <= 1000));
  tft.fillScreen(ILI9341_BLACK);
  tft.setRotation(0);

  splashScreen();

  digitalWrite(PB12, LOW); //s0
  digitalWrite(PB13, LOW); //s1
  digitalWrite(PB14, LOW); //s2

  // Configure the Debouncer
  sw.attach(RELAY_SWITCH, INPUT_PULLUP);
  sw.interval(DEBOUNCETIME);
  effectOff();

  // Signal the user we're ready  blinking
  // bypass led three times
  digitalWrite(RELAY_LED, HIGH); delay(300);
  digitalWrite(RELAY_LED, LOW); delay(300);
  digitalWrite(RELAY_LED, HIGH); delay(300);
  digitalWrite(RELAY_LED, LOW); delay(300);
  digitalWrite(RELAY_LED, HIGH); delay(300);
  digitalWrite(RELAY_LED, LOW); delay(300);
  digitalWrite(RELAY_LED, HIGH);

  updateTime = millis(); // Next update time
  lastMillis = updateTime;
}

void loop()
{
  const uint32_t analogReadInterval = 1;

  // Process button first, to get it ouf ot the way asap
  // and at the same time, keep the on/off more responsive
  if(sw.update())
  {
    if(sw.fell()) 
    {
      if(state == 1)
       effectOff();
      else
       effectOn();
      
      lastMillis = millis();
    }
    else
    {
      if(primetime == 1) 
      {
        effectOff();
        primetime = 0;
      }
    }
  }

  if(state == 1 && (millis() - lastMillis > PRIMETIME) && primetime == 0)
  {
    if(!sw.read()) 
    {
      primetime = 1;
      digitalWrite(RELAY_LED, HIGH); delay(50);
      digitalWrite(RELAY_LED, LOW);  delay(50);
      digitalWrite(RELAY_LED, HIGH); delay(50);
      digitalWrite(RELAY_LED, LOW);
    }
  }

  if (millis() - updateTime >= analogReadInterval) 
  {
    updateTime += analogReadInterval;
    int raw = analogRead(PB0);
    Serial.print("Raw: "), Serial.println(raw);
    reading = map(raw, 0, 4195, 0, 100);
    
    if (meterOn == true)
      plotNeedle(reading, 0); // Draw needle
  }

  p1volts = analogRead(PA0);
  p2volts = analogRead(PA1);
  p3volts = analogRead(PA2);
  p4volts = analogRead(PA4);
  p5volts = analogRead(PA3);

  DrawBarChartP1(tft, 10, 134, 140, 7, 0, 4195 , 409, p1volts, 0, 0, PINK,   DKRED,    BLACK, WHITE, BLACK, "POT1", graph_1);
  DrawBarChartP1(tft, 10, 177, 140, 7, 0, 4195 , 409, p2volts, 0, 0, GREEN,  DKGREY,   BLACK, WHITE, BLACK, "POT2", graph_2);
  DrawBarChartP1(tft, 10, 220, 140, 7, 0, 4195 , 409, p3volts, 0, 0, CYAN,   DKBLUE,   BLACK, WHITE, BLACK, "POT3", graph_3);
  DrawBarChartP1(tft, 10, 263, 140, 7, 0, 4195 , 409, p4volts, 0, 0, RED,    DKGREEN,  BLACK, WHITE, BLACK, "POT4", graph_4);
  DrawBarChartP1(tft, 10, 306, 140, 7, 0, 4195 , 409, p5volts, 0, 0, YELLOW, DKORANGE, BLACK, WHITE, BLACK, "POT5", graph_5);
}

/**
 * switchEffect
 * 
 * switches the current effect
 * changes the UI and loads the effect
 * from FV1
 * 
 * eeprom : either 1 or 2 (any other value is ignored)
 * fxnum : effect number, from 0 to 7
 */
void switchEffect(const char *fxname, uint16_t fxnameX, uint16_t fxnameY,
                  const char *fxtype, uint16_t fxtypeX, uint16_t fxtypeY,
                  const char *knob1,
                  const char *knob2,
                  const char *knob3,
                  bool external, uint8_t eeprom, uint8_t fxnum)
{
  tft.setFont(&TypoHoopRegular20pt7b);
  tft.setTextColor(ILI9341_WHITE);
  tft.setTextSize(1);
  tft.fillRect(0, 0, 240, 100, ILI9341_RED);
  tft.setCursor(fxnameX, fxnameY);
  tft.print(fxname);
  tft.setCursor(fxtypeX, fxtypeY);
  tft.print(fxtype);

  tft.setFont(&TypoHoopRegular10pt7b);
  tft.setTextColor(ILI9341_WHITE);
  tft.fillRect(8, 113, 139, 22, ILI9341_BLACK);
  tft.setCursor(10, 128);
  tft.print(knob1);
  tft.fillRect(8, 156, 138, 22, ILI9341_BLACK);
  tft.setCursor(10, 171);
  tft.print(knob2);
  tft.fillRect(8, 199, 139, 22, ILI9341_BLACK);
  tft.setCursor(10, 214);
  tft.print(knob3);

  // Switch effect

  // External or internal effect
  // High external eeprom, low internal
  digitalWrite(PB4, (external) ? HIGH : LOW);

  // Switch between the 2 eeproms
  if(eeprom == 1)
  {
    digitalWrite(PB7, LOW); //eprom1 on
    digitalWrite(PB5, HIGH); //eprom2 off
  }
  else if(eeprom == 2)
  {
    digitalWrite(PB7, HIGH); //eprom1 off
    digitalWrite(PB5, LOW); //eprom2 on
  }

  // Load FX
  digitalWrite(PB12, HIGH && (fxnum & B00000100)); // S0
  digitalWrite(PB13, HIGH && (fxnum & B00000010)); // S1
  digitalWrite(PB14, HIGH && (fxnum & B00000001)); // S2
  delay(50);
}

/**
 * DrawBarChartP1
 * 
 * Draw Pot values
 */
void DrawBarChartP1(Adafruit_ILI9341 & d, double x , double y , 
                    double w, double h , double loval , double hival , 
                    double inc , double curval ,  int dig , int dec, 
                    unsigned int barcolor, unsigned int voidcolor, 
                    unsigned int bordercolor, unsigned int textcolor, 
                    unsigned int backcolor, String label, boolean & redraw)
{
  double stepval, range;
  double mx, level;
  double i, data;

  if (redraw == true) 
  {
    redraw = false;
    d.drawRect(x , y , w, h, bordercolor);
    stepval =  inc * (double (w) / (double (hival - loval))) - .001;
    for (i = 0; i <= w; i += stepval) {}
  }

  level = (w * (((curval - loval) / (hival - loval))));
  d.fillRect(x + level + 1, y + 1, w - level - 2, h - 2,  voidcolor);
  d.fillRect(x + 1, y + 1 , level - 1,  h - 2, barcolor);
  int sensorValue = analogRead(PB0);

  // Touchscreen

  if (ts.touched()) 
  {
    TS_Point p = ts.getPoint();

    // Button Code
    if (buttonState != lastButtonState)   // compare the buttonState to its previous state
      // save the current state as the last state, for next time through the loop
      lastButtonState = buttonState;

    // Ive had some ili9341 screens with flipped touch pixels,
    // change screen type if up & down & meter buttons dont work, in 3 places below

    if ((p.x > 1350) && (p.x < 2020) && (p.y > 340) && (p.y < 1450)) // Screen type 1
      //if ((p.x < 2762) && (p.x > 2104) && (p.y > 428) && (p.y < 1500)) // Screen type 2
      buttonPushCounter++;

    if (buttonPushCounter >= 22)
      buttonPushCounter = 1;

    meterOn = false;
    delay(200);
    
    if ((p.x > 480) && (p.x < 1100) && (p.y > 340) && (p.y < 1450)) // Screen type 1
      //if ((p.x < 3598) && (p.x > 2998) && (p.y > 428) && (p.y < 1500)) // Screen type 2
      buttonPushCounter--;
    if (buttonPushCounter <= 0)
      buttonPushCounter = 21;
    
    meterOn = false;
      
    if (buttonPushCounter <= 9)
    {
      tft.fillRect(165, 105, 70, 50, ILI9341_BLACK);
      tft.setTextColor(ILI9341_GREEN);
      tft.setTextSize(1);
      tft.setCursor(185, 152);
      tft.setFont(&DSEG7_Classic_Mini_Bold_38);
      tft.print(buttonPushCounter);
    }

    if (buttonPushCounter >= 10)
    {
      tft.fillRect(165, 105, 70, 50, ILI9341_BLACK);
      tft.setTextColor(ILI9341_GREEN);
      tft.setTextSize(1);
      tft.setCursor(165, 152);
      tft.setFont(&DSEG7_Classic_Mini_Bold_38);
      tft.print(buttonPushCounter);
    }

    switch (buttonPushCounter)
    {
      case 1:
        switchEffect("Qubit", 67, 40,
                     "Delay", 67, 85,
                     "Time", "Modulation", "Feedback",
                     1, 1, 0);
        break;
      case 2:
        switchEffect("Supernova", 10, 40,
                     "Delay", 67, 85,
                     "Time", "Filter", "Feedback", 
                     1, 1, 1);
        break;
      case 3:
        switchEffect("Modulated", 10, 43,
                     "Delay", 67, 85,
                     "Time", "Feedback", "Modulation",
                     1, 1, 2);
        break;
      case 4:
        switchEffect("Echo", 75, 40,
                     "Reverb", 50, 85,
                     "Reverb Level", "Delay Time", "Echo Level",
                     1, 1, 3);
        break;
      case 5:
        switchEffect("Shimmer", 30, 40,
                     "Reverb", 50, 85,
                     "Dwell", "Pitch", "Blend",
                     1, 1, 4);
        break;
      case 6:
        switchEffect("Sample &", 25, 40,
                     "Hold", 80, 85,
                     "Time", "Feedback", "Modulation",
                     1, 1, 5);
        break;
      case 7:
        switchEffect("Modulated", 10, 40,
                     "Reverb", 50, 85,
                     "Dwell", "Depth", "Rate",
                     1, 1, 6);
        break;
      case 8:
        switchEffect("Glitch Bit", 30, 40,
                     "Delay", 67, 85,
                     "Delay 1", "Delay 2", "Feedback",
                     1, 1, 7);
        break;
      case 9:
        switchEffect("Daydream", 15, 40,
                     "Delay", 67, 85,
                     "Time", "Feedback", "Filter",
                     1, 2, 0);
        break;
      case 10:
        switchEffect("Starfield", 30, 40,
                     "Delay", 67, 85,
                     "Time", "Feedback", "Phaser",
                     1, 2, 1);
        break;
      case 11:
        switchEffect("Dual Pitch", 20, 40,
                     "Shifter", 51, 85,
                     "Pitch 1", "1-Mix-2", "Pitch 2",
                     1, 2, 2);
        break;
      case 12:
        switchEffect("Triple", 62, 40,
                     "Delay", 67, 85,
                     "Delay 1", "Delay 2", "Delay 3",
                     1, 2, 3);
        break;
      case 13:
        switchEffect("Reverse", 35, 40,
                     "Delay", 67, 85,
                     "Sample", "Feedback", "Delay",
                     1, 2, 4);
        break;
      case 14:
        switchEffect("Wah", 78, 40,
                     "Reverb", 50, 85,
                     "Reverb", "Rate", "Wah",
                     1, 2, 5);
        break;
      case 15:
        switchEffect("Vibrato", 45, 40,
                     "Reverb", 50, 85,
                     "Reverb", "Rate", "Vibrato",
                     1, 2, 6);
        break;
      case 16:
        switchEffect("Phaser", 48, 40,
                     "Reverb", 50, 85,
                     "Reverb", "Rate", "Phaser",
                     1, 2, 7);
        break;
      case 17:
        switchEffect("Chorus", 45, 40,
                     "Reverb", 50, 85,
                     "Reverb", "Rate", "Chorus",
                     0, 0, 0);
        break;
      case 18:
        switchEffect("Flanger", 45, 40,
                     "Reverb", 50, 85,
                     "Reverb", "Rate", "Flanger",
                     0, 0, 1);
        break;
      case 19:
        switchEffect("Tremolo", 35, 40,
                     "Reverb", 50, 85,
                     "Reverb", "Rate", "Tremolo",
                     0, 0, 2);
        break;
      case 20:
        switchEffect("FV-1 Rom", 32, 40,
                     "Reverb 1", 32, 85,
                     "Size", "HF Filter", "LF Filter",
                     0, 0, 6);
        break;
      case 21:
        switchEffect("FV-1 Rom", 32, 40,
                     "Reverb 2", 32, 85,
                     "Size", "HF Filter", "LF Filter",
                     0, 0, 7);
        break;
    }

    // Meter Code -------------------------------------

    if ((p.x > 2880) && (p.x < 3840) && (p.y > 313) && (p.y < 3680)) // Screen type 1
      //if ((p.x < 1300) && (p.x > 257) && (p.y > 381) && (p.y < 3844)) // Screen type 2
    {
      analogMeter(); // Draw analogue meter
      meterOn = true;
    }
  }
}

void analogMeter()
{
  tft.setTextColor(ILI9341_BLACK);  // Text colour
  tft.fillRect(0, 0, 240, 100, meterCream);

  // draw meter background
  int h = 53, w = 240, row, col, buffidx = 0;
 
  for (row = 0; row < h; row++) 
  { // For each scanline...
    for (col = 0; col < w; col++) 
    { // For each pixel...
      //To read from Flash Memory, pgm_read_XXX is required.
      //Since image is stored as uint16_t, pgm_read_word is used as it uses 16bit address
      tft.drawPixel(col, row, pgm_read_word(vumeter + buffidx));
      buffidx++;
    } // end pixel
  }
}

void plotNeedle(int value, byte ms_delay)
{

  if (digitalRead (PB3) == LOW)
    tft.fillCircle(215, 80, 5, 0xc801);

  if (digitalRead (PB3) == HIGH)
    tft.fillCircle(215, 80, 5, meterCream);

  //tft.setTextColor(meterGrey, meterCream);
  //tft.setFont(&FreeMono12pt7b);
  //char buf[8]; dtostrf(value, 4, 0, buf);
  //tft.setCursor(5, 80);
  // tft.print(buf);

  if (value < -10) value = -10; // Limit value to emulate needle end stops
  if (value > 110) value = 110;

  // Move the needle util new value reached
  while (!(value == old_analog)) 
  {
    if (old_analog < value) 
      old_analog++;
    else 
      old_analog--;

    if (ms_delay == 0) 
      old_analog = value; // Update immediately if delay is 0

    float sdeg = map(old_analog, -10, 110, -150, -30); // Map value to angle

    // Calcualte tip of needle coords
    float sx = cos(sdeg * 0.0174532925);
    float sy = sin(sdeg * 0.0174532925);

    // Calculate x delta of needle start (does not start at pivot point)
    float tx = tan((sdeg + 90) * 0.0174532925);

    // Erase old needle image
    tft.drawLine(120 + 20 * ltx - 1, 119 - 20, osx - 1, osy, meterCream); //119
    tft.drawLine(120 + 20 * ltx, 119 - 20, osx, osy, meterCream);
    tft.drawLine(120 + 20 * ltx + 1, 119 - 20, osx + 1, osy, meterCream);

    // Re-plot text under needle
    tft.setTextColor(meterGrey);
    tft.setCursor(87, 83);
    tft.print("1337FX");

    // Store new needle end coords for next erase
    ltx = tx;
    osx = sx * 118 + 120; // 188 + 120
    osy = sy * 38 + 85; // 98 + 140 , 38 + 85

    // Draw the needle in the new postion, magenta makes needle a bit bolder
    // draws 3 lines to thicken needle
    tft.drawLine(120 + 20 * ltx - 1, 119 - 20, osx - 1, osy, 0xc801);
    tft.drawLine(120 + 20 * ltx, 119 - 20, osx, osy, 0xc801);
    tft.drawLine(120 + 20 * ltx + 1, 119 - 20, osx + 1, osy, 0xc801);

    // Slow needle down slightly as it approaches new postion
    // if (abs(old_analog - value) < 10) ms_delay += ms_delay / 5;

    // Wait before next update
    //  delay(ms_delay);
  }
}
