rbarreiros/FV1-Touch/firmware/sketch/pins.h

#ifndef __PINS_H__
#define __PINS_H__

// TFT Chip select and dc pins
#define TFT_DC PB9
#define TFT_CS PB8

// Touchscreen Chip Select pin
#define CS_PIN  PB6

// Relay
// Changed the pins for Lee Nonme
#define RELAY1       PC13
#define RELAY2       PC14
#define RELAY_SWITCH PC15
#define RELAY_LED    PB11

#endif
