rbarreiros/FV1-Touch/firmware/sketch/TypoHoop20pt.h

const uint8_t TypoHoopRegular20pt7bBitmaps[] PROGMEM = {
  0x00, 0x6F, 0xFF, 0xFF, 0xFF, 0xFF, 0xFF, 0xFF, 0xFF, 0xFF, 0xF6, 0x00,
  0x00, 0x06, 0xF6, 0x61, 0xBC, 0xFF, 0x3F, 0xCF, 0xF3, 0xFC, 0xFF, 0x3F,
  0xCF, 0xF3, 0xD8, 0x60, 0x03, 0x03, 0x00, 0x1E, 0x1E, 0x00, 0x78, 0x78,
  0x01, 0xE1, 0xE0, 0x07, 0x87, 0x80, 0x1E, 0x1E, 0x00, 0x78, 0x78, 0x01,
  0xE1, 0xE0, 0xFF, 0xFF, 0xFF, 0xFF, 0xFF, 0xFF, 0xFF, 0xFF, 0xC1, 0xE1,
  0xE0, 0x07, 0x87, 0x80, 0x1E, 0x1E, 0x00, 0x78, 0x78, 0x01, 0xE1, 0xE0,
  0xFF, 0xFF, 0xFF, 0xFF, 0xFF, 0xFF, 0xFF, 0xFF, 0xC1, 0xE1, 0xE0, 0x07,
  0x87, 0x80, 0x1E, 0x1E, 0x00, 0x78, 0x78, 0x01, 0xE1, 0xE0, 0x07, 0x87,
  0x80, 0x1E, 0x1E, 0x00, 0x30, 0x30, 0x00, 0x03, 0x80, 0x03, 0x80, 0x03,
  0x80, 0x07, 0xC0, 0x1F, 0xF0, 0x3F, 0xF8, 0x7F, 0xFC, 0x7B, 0xBC, 0xF3,
  0x9C, 0xF3, 0x8C, 0xF3, 0x80, 0xF3, 0x80, 0xF3, 0x80, 0xFB, 0x80, 0x7F,
  0x80, 0x7F, 0xE0, 0x3F, 0xF8, 0x07, 0xFC, 0x03, 0xFE, 0x03, 0xBF, 0x03,
  0x9F, 0x03, 0x8F, 0xE3, 0x8F, 0xF3, 0x8F, 0xF3, 0x9F, 0x7B, 0xBE, 0x7F,
  0xFE, 0x3F, 0xFC, 0x1F, 0xF0, 0x07, 0xC0, 0x03, 0x80, 0x03, 0x80, 0x03,
  0x80, 0x00, 0x00, 0x00, 0x0F, 0x80, 0x0E, 0x0F, 0xF0, 0x0F, 0x0F, 0xFC,
  0x07, 0x8F, 0x9F, 0x07, 0x87, 0x87, 0x87, 0xC3, 0xC3, 0xC3, 0xC1, 0xE1,
  0xE3, 0xC0, 0xF9, 0xF3, 0xE0, 0x3F, 0xF1, 0xE0, 0x0F, 0xF1, 0xE0, 0x03,
  0xF1, 0xF0, 0x00, 0x00, 0xF0, 0x00, 0x00, 0xF0, 0x00, 0x00, 0xF8, 0x00,
  0x00, 0xF8, 0x00, 0x00, 0x78, 0x00, 0x00, 0x7C, 0x7E, 0x00, 0x7C, 0x7F,
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
  {  2071,  19,  27,  21,    2,  -26 },   // 0x46 'F'
  {  2136,  27,  27,  29,    1,  -26 },   // 0x47 'G'
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

const GFXfont TypoHoopRegular20pt7b PROGMEM = {
  (uint8_t  *)TypoHoopRegular20pt7bBitmaps,
  (GFXglyph *)TypoHoopRegular20pt7bGlyphs,
  0x20, 0x7E, 45 };

// Approx. 6428 bytes
