rbarreiros/FV1-Touch/firmware/sketch/Typohoop10pt.h

const uint8_t TypoHoopRegular10pt7bBitmaps[] PROGMEM = {
  0x00, 0xFF, 0xFF, 0xF0, 0xF0, 0xDE, 0xF7, 0xBD, 0x80, 0x1B, 0x03, 0x60,
  0x6C, 0x0D, 0x8F, 0xFF, 0xFF, 0xC6, 0xC0, 0xD8, 0xFF, 0xFF, 0xFC, 0x6C,
  0x0D, 0x81, 0xB0, 0x36, 0x00, 0x18, 0x18, 0x7E, 0x7F, 0xDB, 0xD8, 0xD8,
  0xF8, 0x7E, 0x1F, 0x1B, 0x9B, 0xDB, 0xFE, 0x7E, 0x18, 0x18, 0x78, 0x27,
  0xE3, 0xB3, 0x19, 0x99, 0x8F, 0xDC, 0x3C, 0xC0, 0x0C, 0x00, 0xE0, 0x06,
  0xF0, 0x6F, 0xC7, 0x66, 0x33, 0x33, 0x1F, 0x98, 0x78, 0x3E, 0x07, 0xF0,
  0xE1, 0x8C, 0x18, 0xC0, 0x0E, 0x18, 0x7F, 0xF7, 0xFF, 0xE1, 0x8C, 0x18,
  0xC1, 0x8E, 0x3C, 0x7F, 0xF3, 0xE7, 0xFF, 0xC0, 0x0C, 0x73, 0x8C, 0x61,
  0x8C, 0x30, 0xC3, 0x0C, 0x30, 0xC1, 0x86, 0x0C, 0x38, 0x70, 0xC0, 0xC3,
  0x87, 0x0C, 0x18, 0x61, 0xC3, 0x0C, 0x30, 0xC3, 0x1C, 0x61, 0x8C, 0x73,
  0x8C, 0x00, 0x0C, 0x03, 0x00, 0xC3, 0xFF, 0x3F, 0x07, 0x83, 0xF0, 0xCC,
  0x21, 0x00, 0x0C, 0x06, 0x03, 0x1F, 0xFF, 0xF8, 0x60, 0x30, 0x18, 0x0C,
  0x00, 0x6D, 0x6C, 0xFF, 0xFC, 0xFF, 0xFC, 0x6C, 0x67, 0x73, 0x00, 0x19,
  0xDE, 0xDE, 0xF6, 0xF7, 0x30, 0x01, 0x82, 0x0F, 0x2A, 0xEB, 0xD7, 0x00,
  0x1B, 0x92, 0xEF, 0xD6, 0x08, 0x30, 0x41, 0xFF, 0xF8, 0x02, 0x0C, 0x18,
  0x60, 0xC3, 0x06, 0x0C, 0x30, 0x61, 0x83, 0x0C, 0x18, 0x00, 0x1F, 0x07,
  0xF1, 0xC7, 0x30, 0x6C, 0x07, 0x80, 0xF0, 0x1E, 0x03, 0xC0, 0x78, 0x0D,
  0x83, 0x38, 0xE3, 0xF8, 0x3E, 0x00, 0x7D, 0xF0, 0xC3, 0x0C, 0x30, 0xC3,
  0x0C, 0x30, 0xC3, 0x0C, 0x30, 0x3E, 0x3F, 0xB8, 0xF8, 0x3C, 0x18, 0x0C,
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
  {   547,   9,  14,  11,    1,  -13 },   // 0x46 'F'
  {   563,  14,  14,  16,    1,  -13 },   // 0x47 'G'
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

const GFXfont TypoHoopRegular10pt7b PROGMEM = {
  (uint8_t  *)TypoHoopRegular10pt7bBitmaps,
  (GFXglyph *)TypoHoopRegular10pt7bGlyphs,
  0x20, 0x7E, 23 };

// Approx. 2179 bytes
