rbarreiros/FV1-Touch/firmware/sketch/digi.h

// Created by http://oleddisplay.squix.ch/ Consider a donation
// In case of problems make sure that you are using the font file with the correct version!
const uint8_t DSEG7_Classic_Mini_Bold_38Bitmaps[] PROGMEM = {

  // Bitmap Data:
  0x00, // ' '
  0x00, // '!'
  0xFF,0xD0,0x0A,0x01,0x40,0x28,0x05,0x00,0xA0,0x14,0x02,0x80,0x50,0x0A,0x01,0x40,0x28,0x05,0x00,0xA0,0x14,0x02,0x80,0x50,0x0A,0x01,0x40,0x28,0x05,0x00,0xA0,0x14,0x02,0xFF,0xC0, // '"'
  0xFF,0xD0,0x0A,0x01,0x40,0x28,0x05,0x00,0xA0,0x14,0x02,0x80,0x50,0x0A,0x01,0x40,0x28,0x05,0x00,0xA0,0x14,0x02,0x80,0x50,0x0A,0x01,0x40,0x28,0x05,0x00,0xA0,0x14,0x02,0xFF,0xC0, // '#'
  0xFF,0xD0,0x0A,0x01,0x40,0x28,0x05,0x00,0xA0,0x14,0x02,0x80,0x50,0x0A,0x01,0x40,0x28,0x05,0x00,0xA0,0x14,0x02,0x80,0x50,0x0A,0x01,0x40,0x28,0x05,0x00,0xA0,0x14,0x02,0xFF,0xC0, // '$'
  0xFF,0xD0,0x0A,0x01,0x40,0x28,0x05,0x00,0xA0,0x14,0x02,0x80,0x50,0x0A,0x01,0x40,0x28,0x05,0x00,0xA0,0x14,0x02,0x80,0x50,0x0A,0x01,0x40,0x28,0x05,0x00,0xA0,0x14,0x02,0xFF,0xC0, // '%'
  0xFF,0xD0,0x0A,0x01,0x40,0x28,0x05,0x00,0xA0,0x14,0x02,0x80,0x50,0x0A,0x01,0x40,0x28,0x05,0x00,0xA0,0x14,0x02,0x80,0x50,0x0A,0x01,0x40,0x28,0x05,0x00,0xA0,0x14,0x02,0xFF,0xC0, // '&'
  0xFF,0xD0,0x0A,0x01,0x40,0x28,0x05,0x00,0xA0,0x14,0x02,0x80,0x50,0x0A,0x01,0x40,0x28,0x05,0x00,0xA0,0x14,0x02,0x80,0x50,0x0A,0x01,0x40,0x28,0x05,0x00,0xA0,0x14,0x02,0xFF,0xC0, // '''
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
    {  1596,  11,  25,  15,    1,  -25 }, // '?'
    {  1631,  11,  25,  15,    1,  -25 }, // '@'
    {  1666,  24,  35,  32,    4,  -38 }, // 'A'
    {  1771,  24,  35,  32,    4,  -35 }, // 'B'
    {  1876,  21,  21,  32,    4,  -21 }, // 'C'
    {  1932,  24,  35,  32,    4,  -35 }, // 'D'
    {  2037,  21,  38,  32,    4,  -38 }, // 'E'
    {  2137,  21,  35,  32,    4,  -38 }, // 'F'
    {  2229,  24,  38,  32,    4,  -38 }, // 'G'
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
};
const GFXfont DSEG7_Classic_Mini_Bold_38 PROGMEM = {
(uint8_t  *)DSEG7_Classic_Mini_Bold_38Bitmaps,(GFXglyph *)DSEG7_Classic_Mini_Bold_38Glyphs,0x20, 0x7E, 42};
