rbarreiros/FV1-Touch/firmware/sketch/meter.h

#ifndef VUMETER_H
#define VUMETER_H

// icon size: 240W*53H
const uint16_t vumeter[] PROGMEM ={
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
};

#endif
