rbarreiros/FV1-Touch/firmware/sketch/colors.h

#ifndef __COLORS_H__
#define __COLORS_H__

#define meterGrey       0x62c7
#define meterCream      0xd610
#define LTBLUE          0xB6DF
#define LTTEAL          0xBF5F
#define LTGREEN         0xBFF7
#define LTCYAN          0xC7FF
#define LTRED           0xFD34
#define LTMAGENTA       0xFD5F
#define LTYELLOW        0xFFF8
#define LTORANGE        0xFE73
#define LTPINK          0xFDDF
#define LTPURPLE        0xCCFF
#define LTGREY          0xE71C

#define BLUE            0x001F
#define TEAL            0x0438
#define GREEN           0x07E0
#define CYAN            0x07FF
#define RED             0xF800
#define MAGENTA         0xF81F
#define YELLOW          0xFFE0
#define ORANGE          0xFD20
#define PINK            0xF81F
#define PURPLE          0x801F
#define GREY            0xC618
#define WHITE           0xFFFF
#define BLACK           0x0000

#define DKBLUE          0x000D
#define DKTEAL          0x020C
#define DKGREEN         0x32A3
#define DKCYAN          0x03EF
#define DKRED           0x6000
#define DKMAGENTA       0x8008
#define DKYELLOW        0x8400
#define DKORANGE        0x8200
#define DKPINK          0x9009
#define DKPURPLE        0x4010
#define DKGREY          0x4A49

#endif
