rbarreiros/FV1-Touch/(commit log)

2019-11-26 Initial Import
    [FV1 Touch.brd, FV1 Touch.sch]
2019-11-27 Moved stuff Cleaned up plenty of code, pretty sure that can be better. Added the relay code
2019-11-29 Removed the EEPROM code for the relay switch. Forced input pull up on the relay switch (on pinmode and debounce attach) Added to the repo the compiled version
2019-11-29 Modified pins for the relay for Lee Nonme connections
2019-11-29 Forced effect off after the pin setup
