rbarreiros/FV1-Touch/Images/IMG_5131.jpeg

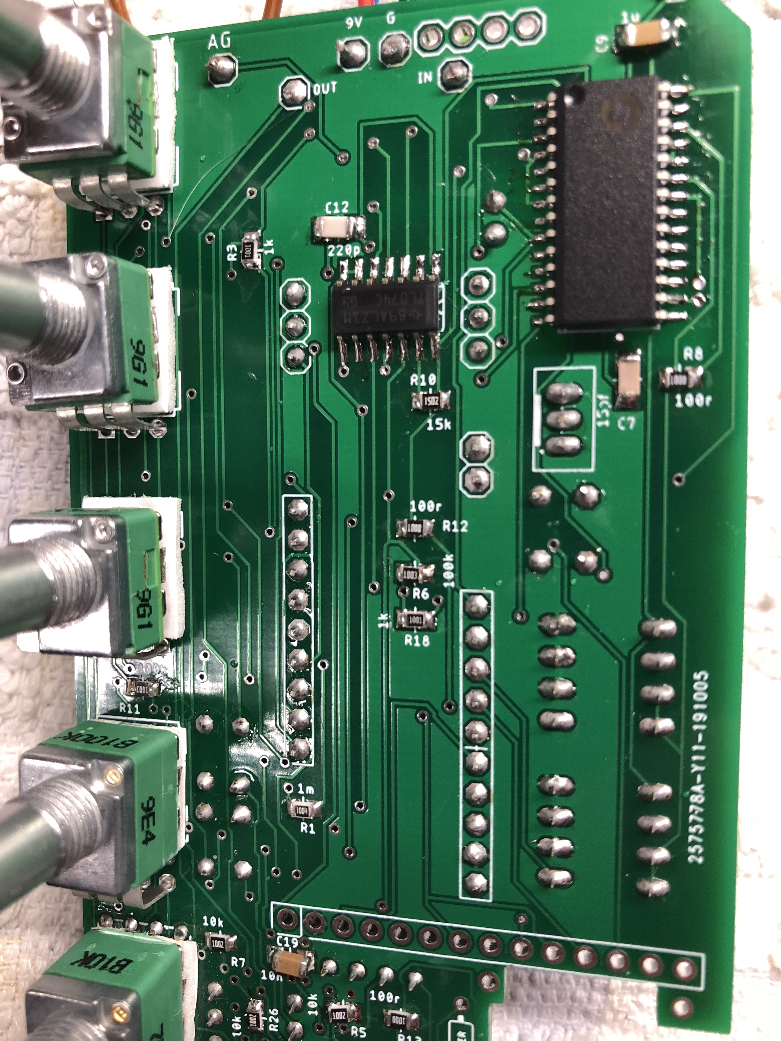
Images/IMG_5131.jpeg
