rbarreiros/FV1-Touch/Images/IMG_5138.jpeg

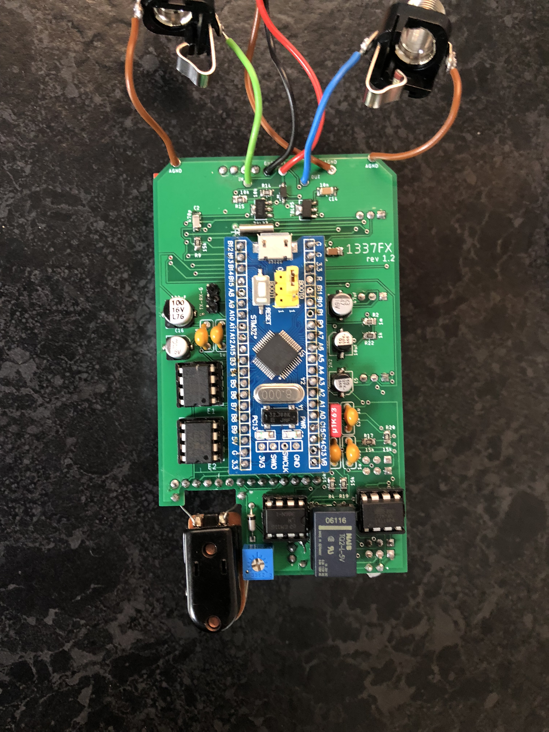
Images/IMG_5138.jpeg
