rbarreiros/FV1-Touch/Images/IMG_5156.jpeg

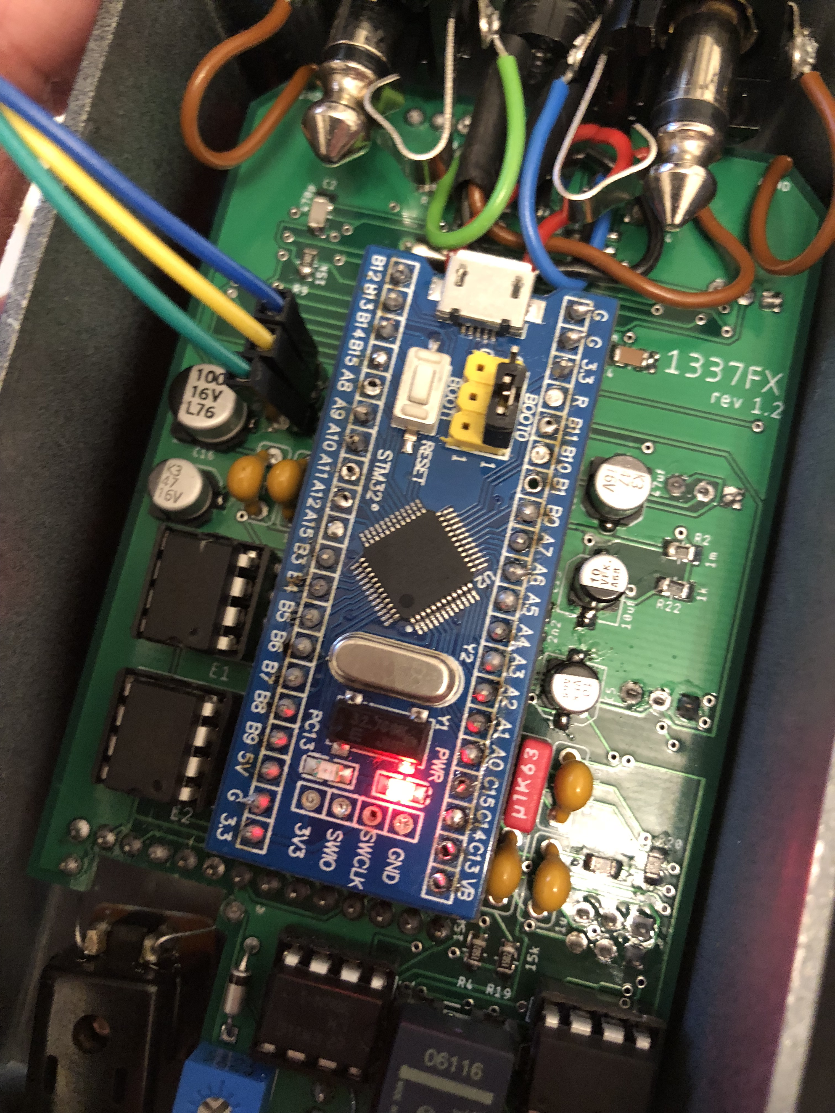
Images/IMG_5156.jpeg
